opticsensors/monitoring-injection-molding/README.md

# `monitoring-injection-molding`
Integration of temperature and pressure sensors inside the cavity of an injection mold with real-time monitoring. Automatic cycle detection via an inductive proximity sensor or machine trigger. The machine signals (injection pressure, screw speed and screw position) are read on the same DAQ scan as the in-mold sensors, so each detected cycle is saved with all channels time-aligned.

The planned [inspection cell](inspection_cell/README.md) has its own hardware,
software and validation workspace in this repository. It documents automatic
spiral length/diameter measurement and weighing, including the initial Machina
proposal and source files. The cell is still in design; acquisition software is
not yet implemented there.

# Hardware

UPDATE photos: added new connector for machine outputs and rewired 

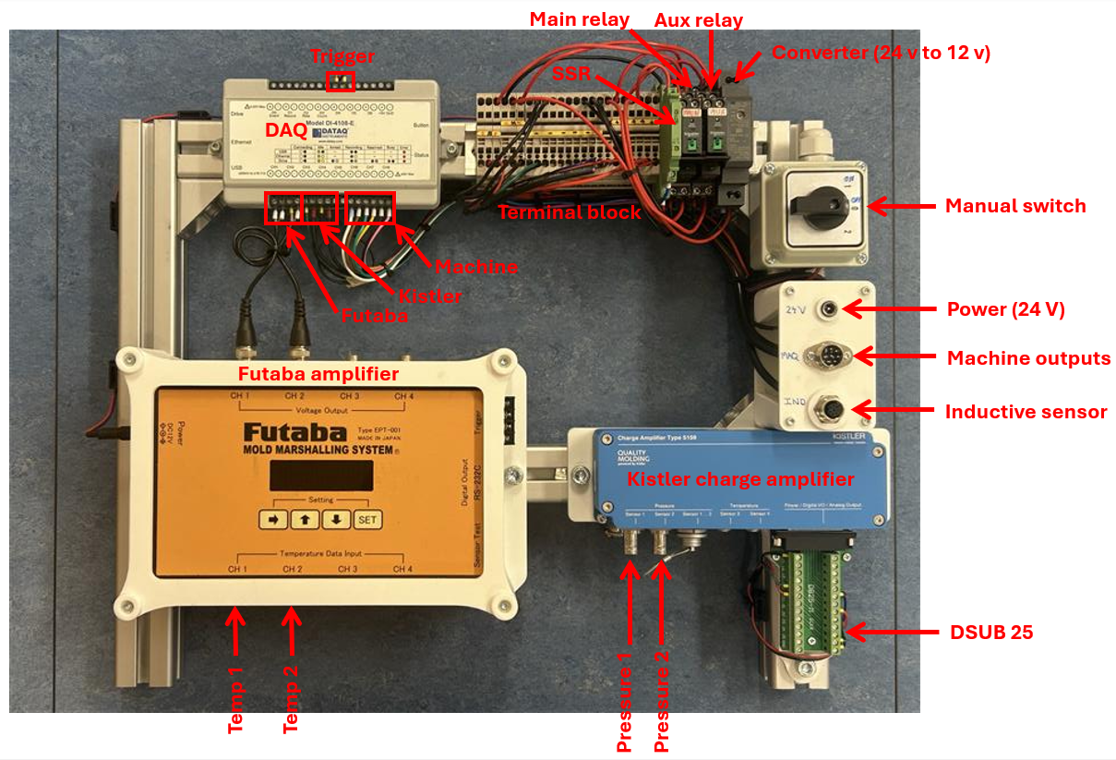
[picture p1: figures/hardware.png]


## Mold sensors:

| Kistler Piezoelectric (0–2000 bar) | Futaba IR (60–430 ºC) | Inductive Proximity | 
|:---:|:---:|:---:|
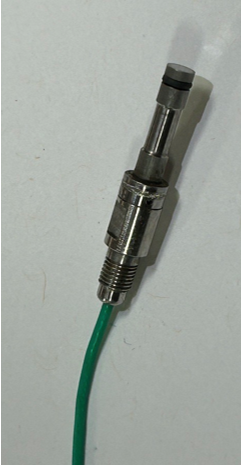
[picture p2: figures/pressure.png]
a
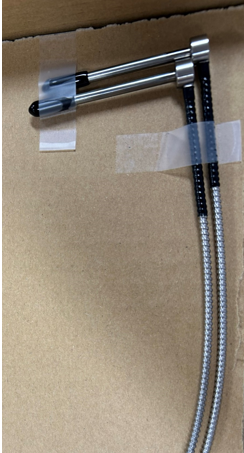
[picture p3: figures/futaba ir.png]
b
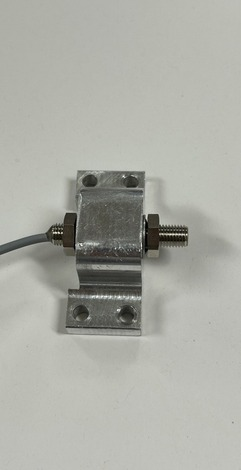
[picture p4: figures/inductive.jpg]
c
|  |  |  |

**Why piezoelectric over piezoresistive?**
Injection molding involves rapid pressure spikes during filling. Piezoelectric sensors excel at capturing these fast, dynamic events with high linearity and are robust under high pressures and temperatures. However, they require charge amplifiers and are unsuitable for long-term static measurements due to drift.

**Why IR over thermocouple?**
IR sensors offer non-contact, fast-response measurement (<8ms) of melt temperature, unaffected by mold conduction. Thermocouples, though cost-effective, can have their melt temperature readings altered by heat conduction from the surrounding mold steel.

## Circuit

The three trigger sources (manual switch, inductive proximity sensor and machine signal) are wired **in parallel onto the main relay coil**, so any of them energizes it and all can be active at the same time.

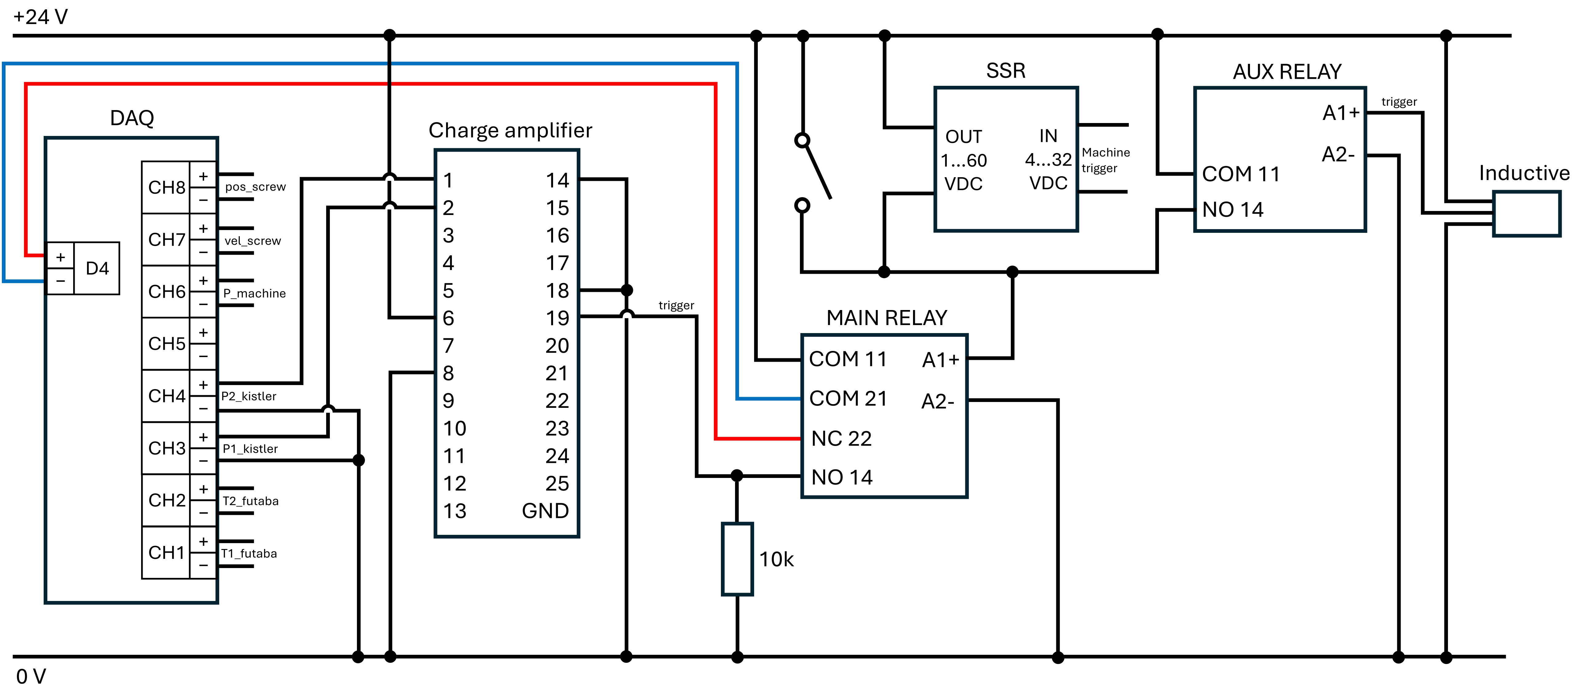
[picture p5: figures/circuit3.png]
Circuit schematic


**Relay Logic**
- Auxiliary relay: converts the inductive sensor's electronic output into a mechanical contact, protecting the sensor electronics from the manual switch's direct 24 V supply.
- Solid-state relay: acts as a switch driven by the machine's 0–10 V output, keeping the machine side isolated from the coil.
- Main relay: two poles. Pole 1 applies the 24 V reset signal to the charge amplifier's trigger/reset input (pin 19), discharging its internal capacitance to eliminate drift; pole 2 (COM 21 / NC 22) is a free contact wired to a DAQ digital input, which tells the program when to record.

**Dry Contact**
The DAQ digital inputs are idle-HIGH (internal pull-up) and only react to being pulled down to ground, hence the voltage-free contact: relay released, the input is grounded and reads 0; relay energized, the contact opens and it reads 1 = cycle running.

**Pull-Down Resistor (10 kΩ)**
Between the main relay's NO contact and ground, it holds the charge amplifier's trigger pin at a defined LOW (0 V) while the relay is open, preventing false triggering from electrical noise.

## Unit conversions:

Every channel is read as a raw ADC count and first scaled to volts. The DAQ input range is ±10 V with a 16-bit signed converter, so 32768 counts = 10 V:

`V = raw × 10 / 32768`

**This application requires ±10 V on every acquired analog channel. Do not change
the input range.** The GUI displays a fixed range and the app enforces it, including
when loading configuration files. The shared `daq_connectivity` library continues
to support other ranges for other applications.

That voltage is then converted per channel type. The values below are the defaults in `config/daq_config_defaults.json`. For the machine signals, `R` is the resolution given by the machine (mV per unit) and `initial` the value at 0 V.

| Signal | Conversion | Default |
|---|---|---|
| Futaba (`T_futaba`) | `°C = V × deg_per_volt` | 100 °C/V |
| Kistler (`P_kistler`) | `bar = V × (Qmax / s) / 10` | Qmax = 20000 pC, s = 2.500 |
| Injection pressure (`P_machine`) | `bar = initial + mV / R` | R = 20 mV, initial = 0 |
| Injection speed (`vel_screw`) | `cm³/s = initial + mV / R` | R = 100 mV, initial = 0 |
| Screw position (`pos_screw`) | `mm = initial + mV / R` | R = 100 mV, initial = 0 |

# Software

UPDATE demo and software (leave that as a reminder for me)

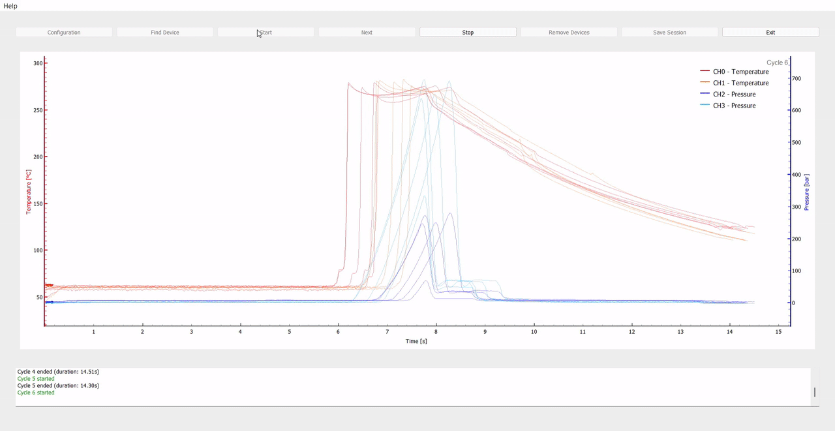
[picture p6: figures/monitoring.gif]
Demo


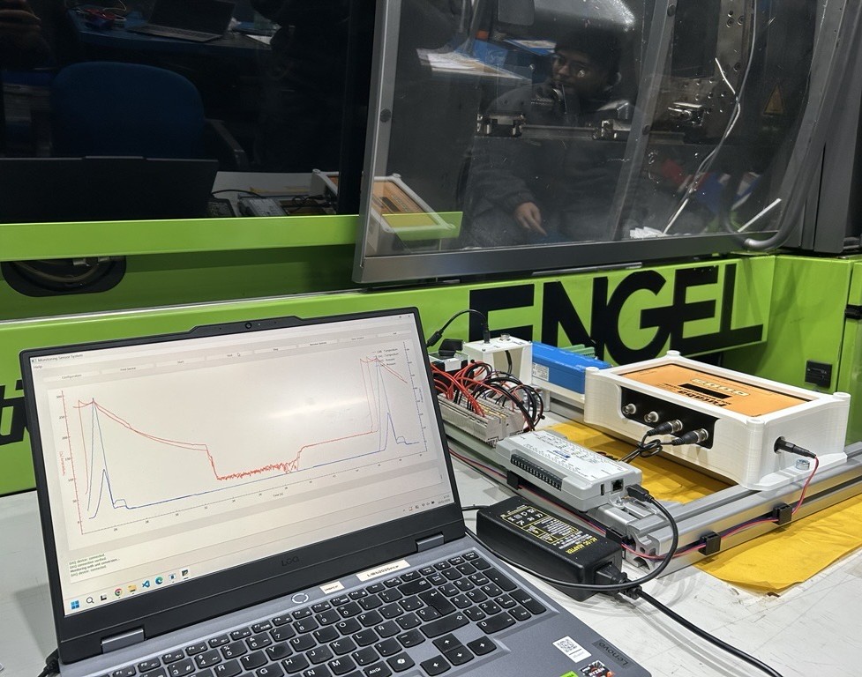
[picture p7: figures/integration.jpg]


Run the application with `py -3.11 main.py`.

- **Setup:** embedded DAQ, Mold sensors, Machine data and Display tabs. Connect/Disconnect controls the single DAQ. Save configuration stages changes for the next recording; Display includes Automatic upload.
- **Monitor:** Start/Stop, New session, Save/Send and plot tools share one toolbar. Enter Machine/Material/Mold/Melt/Speed before Start; they stay fixed for that session. New session focuses these inputs without clearing the stopped recording. Start begins the next session.
- **Part measurements:** Weight/Spiral save automatically after a short pause, Enter or focus change. Monitor follows trigger starts; a field being edited stays attached to its original cycle until you leave it.
- **History:** edit Machine or Material through Spiral directly in a cell. One load icon fetches pages of 10, then refreshes loaded identities and the newest page. Check/select rows to Plot, Exclude, Restore or Send edits.
- **Plots:** each comparison opens in its own closable tab. Its tools and selected-cycle calculations stay independent of Monitor.
- **Offline edits:** pending corrections survive restarts. They send with automatic upload or explicit Send edits; History readback confirms synchronization. Original captures and waveforms remain intact.
- **Save:** exports waveform `.csv`, cycle summary `.cycles.csv`, and `.metadata.json`. Summaries show corrected settings; excluded cycles remain marked in the export. Save again after edits.

MQTT and History share a commissioning `.env` (see [.env.example](.env.example)).
For a OneDrive checkout it lives at `%LOCALAPPDATA%\InjectionMonitoring\.env`;
otherwise the default is the repository's `.env`. `MONITORING_ENV_FILE` overrides
the location for both services. Keep the actual file outside OneDrive and Git.
Set `HISTORY_URL` and `HISTORY_TOKEN` once using the [server guide](iot/SERVER_SETUP.md#desktop-history).
Connection messages appear in the bottom log. Online History and machine corrections require the [server update](iot/SERVER_SETUP.md#desktop-history).

The approved Full inspector layout is shared by `main.py` and the offline demo:
`py -3.11 scripts/preview_layouts.py`. The demo uses synthetic acquisition, a
25-cycle in-memory server and disposable settings; it never opens the DAQ or a
network connection. To render review images, add
`--screenshots data/previews/inspector`.

The inspector defaults to 250 px. Session settings appear only in Monitor;
Setup and History use the full width. Trigger sits below DAQ settings and Machine
variables fills the same width as the other groups. Icons have short tooltips;
their source and license are in `assets/preview/lucide/`.
Analog and digital tables fit their contents without a blank bottom strip;
machine conversion values are centered in their numeric cells.

Measurements entered during an active cycle are saved separately in
`data/active_part_measurements.json`, then transferred to its completed record.
Unfinished measurements after a restart, or measurements from discarded trigger
noise, are retained in that file for recovery and never attached to a new cycle.
Waveforms still require explicit Save or server storage.

## Machine validation

Follow [MACHINE_TEST.md](MACHINE_TEST.md) for a supervised injection test, scan-loss
diagnostics, local exports and server checks. Launch the normal GUI with scan
accounting using `py -3.11 scripts/validate_acquisition.py`.

Use a known-working trigger source. **Machine mold position has an accepted
hardware limitation:** with the documented relay wiring it can keep the Kistler
amplifiers in reset during injection. Software inversion cannot recover that
pressure signal. Repair is deferred; the other working trigger methods remain
available for testing and recording.

The **Sampling divisor (srate)** field is the existing DAQ command parameter,
not a frequency in Hz. Its value, decimation and hardware commands are unchanged.

# IoT

Deploy/update the server from **PowerShell in this repository**:

```powershell
powershell -ExecutionPolicy Bypass -File .\scripts\deploy.ps1
```

Includes Node-RED and Grafana setup. [Server guide and troubleshooting](iot/SERVER_SETUP.md).

Connect to the server:

```shell
ssh -l 'eduard.almar@local.eurecat.org' 172.20.48.28
```

| Service | URL |
|---|-----|
| Grafana | http://172.20.48.28:3000/ |
| Node-RED | http://172.20.48.28:1880/ |

Grafana shows the latest cycles from **55t and 160t combined** (max 100).
This release requires database migrations through **005**, Node-RED and the dashboard together.
Use the deployment command above before using the new desktop's correction features.

Query/export InfluxDB waveforms from a local **WSL/Linux terminal**:

```shell
# Last 5 rows
ssh -l 'eduard.almar@local.eurecat.org' 172.20.48.28 "docker exec influxdb influx -database sensor_data -execute 'SELECT * FROM sensor_data ORDER BY time DESC LIMIT 5'"

# Download CSV
ssh -l 'eduard.almar@local.eurecat.org' 172.20.48.28 "docker exec influxdb influx -database sensor_data -execute 'SELECT * FROM sensor_data' -format csv" > /mnt/c/Users/eduard.almar/Downloads/sensor_data_dump.csv
```

# Installation Manual

## Futaba

| Step | Description | Reference |
|---|---|---|
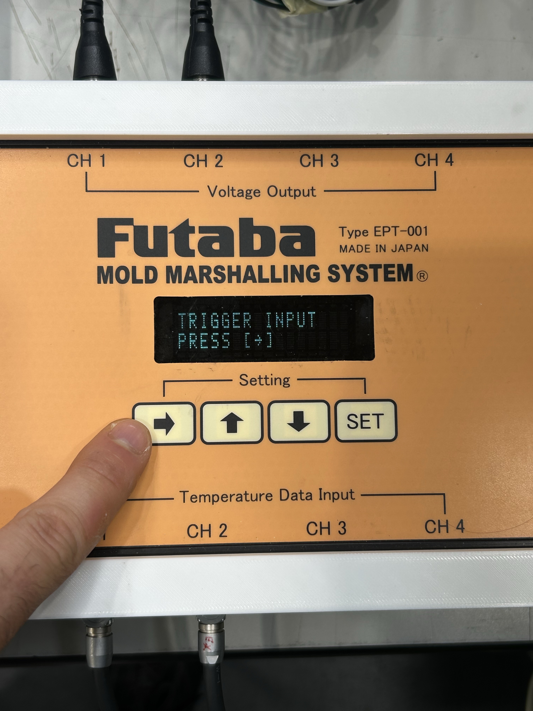
[picture p8: figures/Futaba calibration.jpg]
Futaba calibration
| 1 | Press the calibration button of the amplifier **with the mold open**. |  |
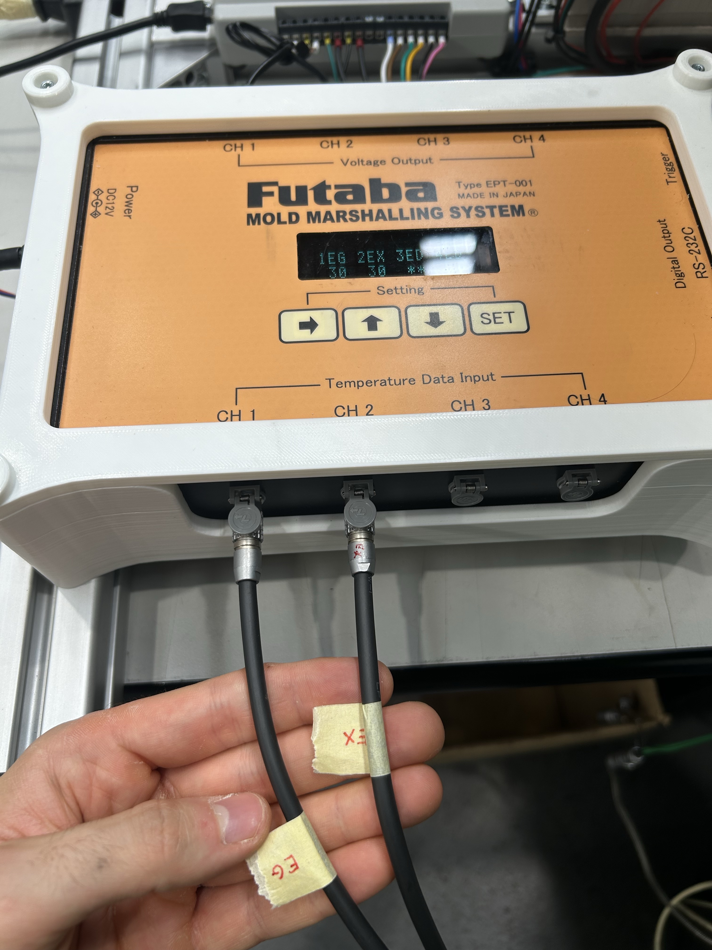
[picture p9: figures/Futaba inputs.jpg]
Futaba inputs
| 2 | Connect the Futaba inputs. |  |
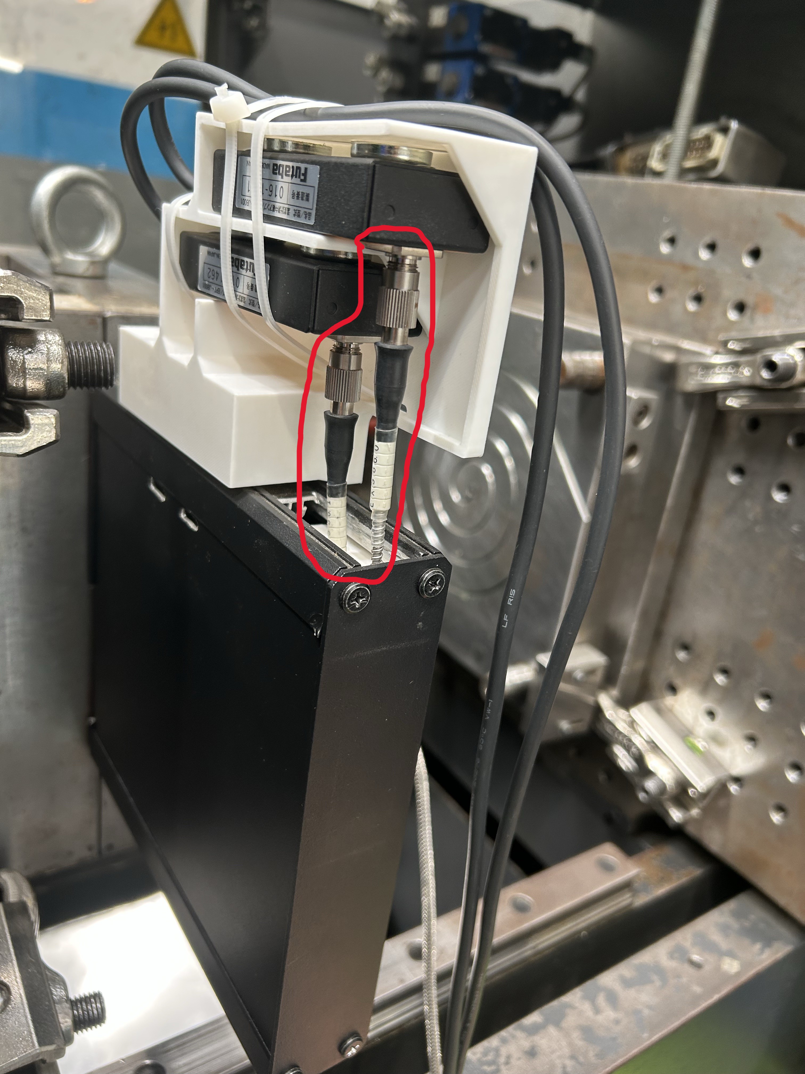
[picture p10: figures/Futaba preamplifiers installation 2.jpg]
Futaba preamplifiers
| 3 | Connect the cables that stick out of the box to the preamplifiers. |  |
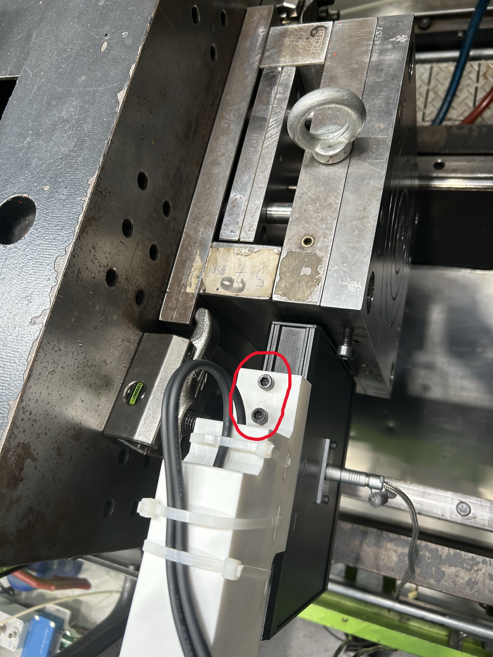
[picture p11: figures/Futaba preamplifiers installation.jpg]
Futaba mounting
| 4 | Secure the preamplifiers using the threaded screws. |  |

## Kistler

| Step | Description | Reference |
|---|---|---|
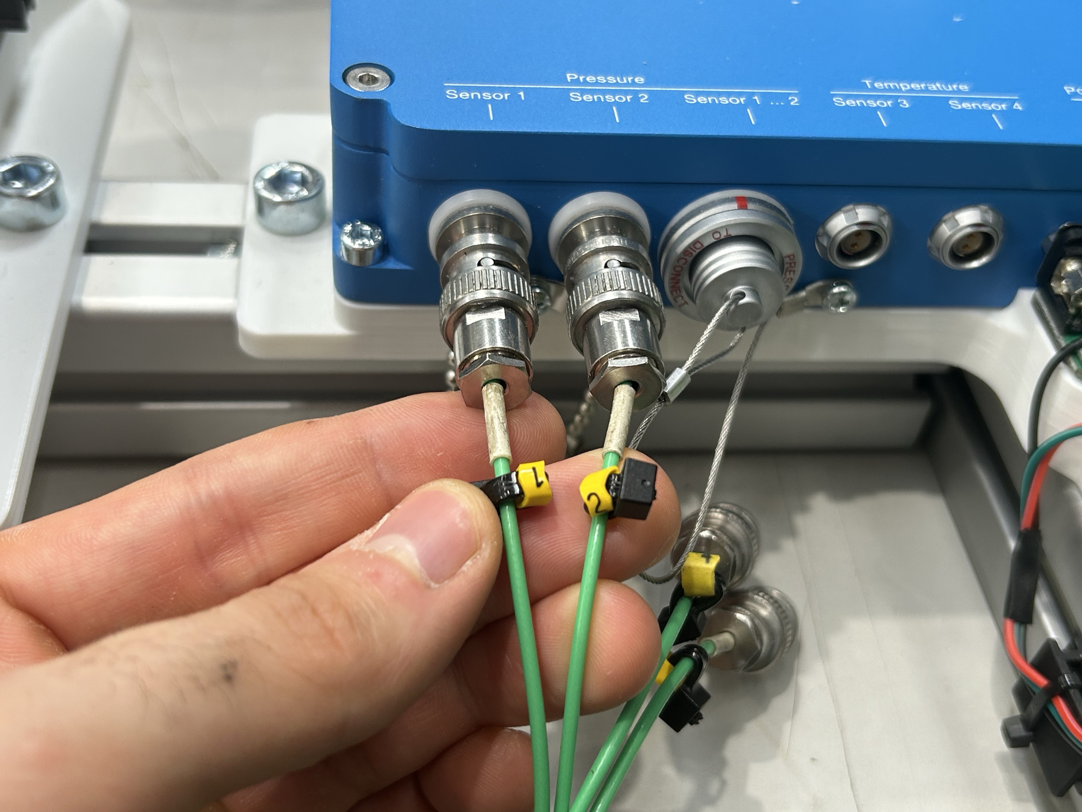
[picture p12: figures/Kistler inputs.jpg]
Kistler inputs
| 1 | Connect the Kistler inputs 1 and 2. |  |
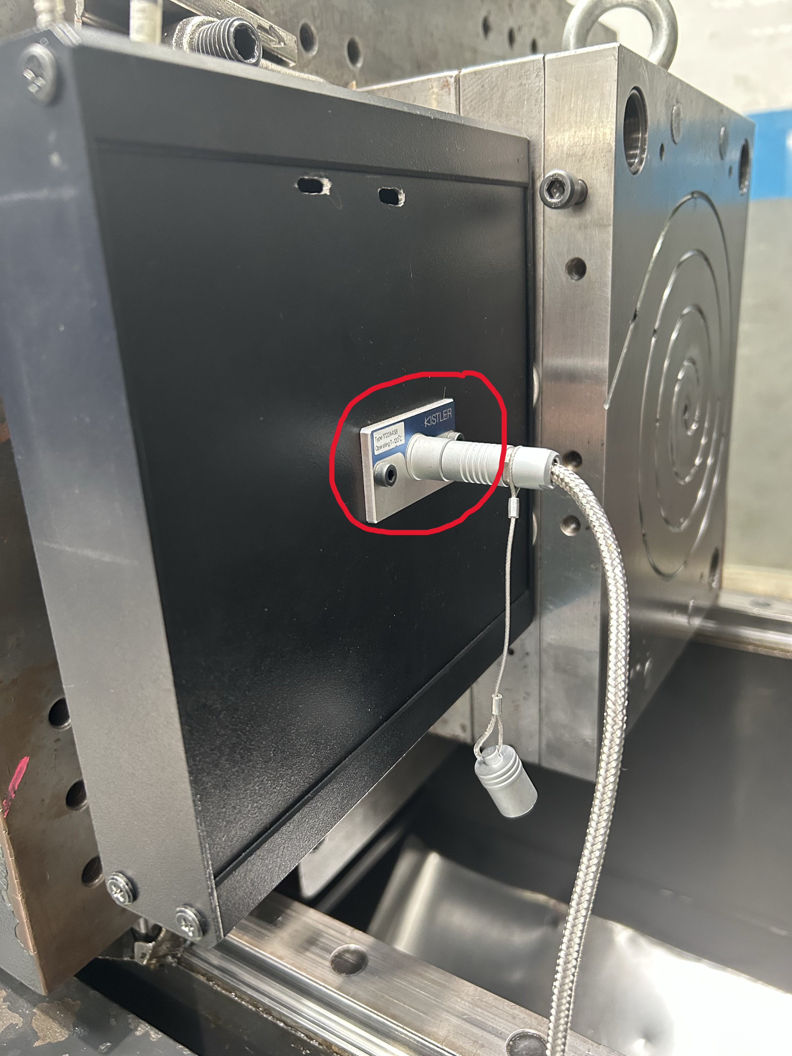
[picture p13: figures/Mold pressure outputs.jpg]
Kistler outputs
| 2 | Connect the mold pressure outputs. |  |

## Final Installation

| Expected result |
|-----------------|
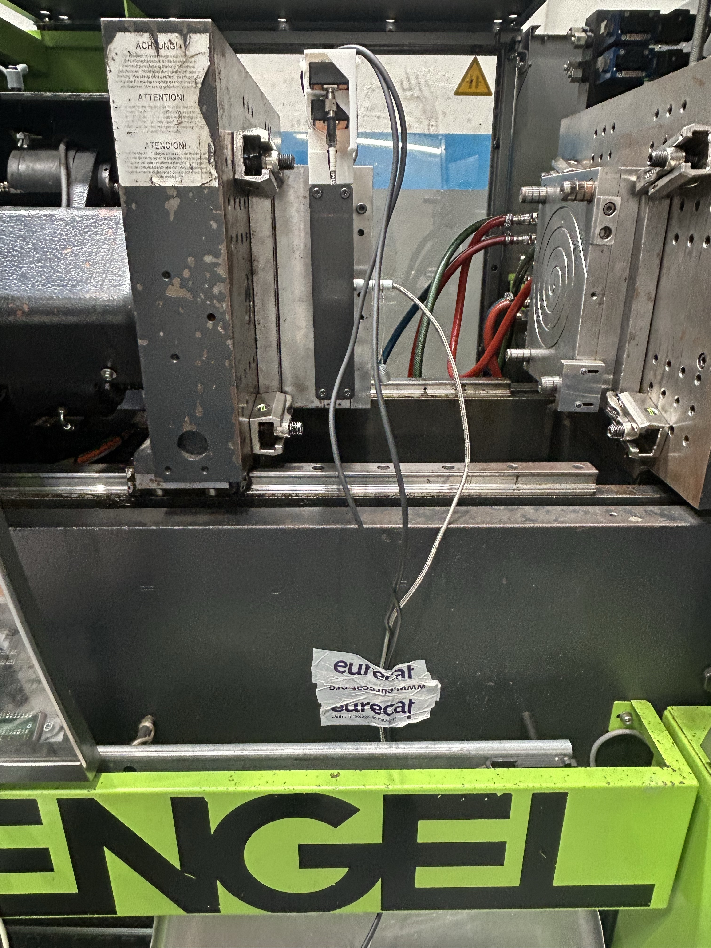
[picture p14: figures/Final result.jpg]
Final installation
|  |
