opticsensors/monitoring-injection-molding/inspection_cell/hardware/README.md

# Hardware de la celda

Estado: concepto inicial, selección pendiente. El punto de partida es cámara 2D cenital, iluminación posterior, soporte transparente, báscula y estructura de perfiles.

| Área | Contenido |
| --- | --- |
| [Investigación](research/README.md) | Qué comparar, por qué y cómo comprobarlo |
| [Componentes](components/README.md) | Candidatos, fichas, oferta y BOM preliminar |
| [Mecánica](mechanical/README.md) | Estructura, colocación, referencias geométricas y CAD |
| [Electricidad](electrical/README.md) | Alimentaciones, conexiones y organización del cableado |
| [Validación](../validation/README.md) | Pruebas antes de aceptar el diseño |

## Orden de trabajo

1. Concretar la magnitud a medir, colada, peso y estado térmico de la pieza.
2. Probar una muestra real sobre una superficie iluminada, con altura y apoyo controlados.
3. Comprobar FOV, escala, deformación, bordes y repetibilidad con óptica/cámara candidatas.
4. Definir la ruta de carga de la báscula y probar lectura automática estable.
5. Dimensionar estructura, fijaciones, conexiones y accesorios con esos resultados.
6. Actualizar selección y BOM con referencias exactas y costes vigentes.

No hay planos de fabricación ni equipos aprobados. Los CAD recibidos pertenecen a la pieza/molde de referencia; no constituyen un diseño de la nueva celda.
