opticsensors/monitoring-injection-molding/inspection_cell/hardware/mechanical/cad/README.md

# CAD

[reference/](reference/README.md) contiene los ficheros recibidos de pieza, molde y elementos asociados. Se copiaron como contexto; no se han abierto en SolidWorks ni se ha comprobado la resolución de enlaces del ensamblaje.

Los futuros diseños de la celda deberán separarse de esas referencias y organizarse por estructura/fixture con revisión y unidades. Añadir, cuando existan, formato nativo, exportación neutral y plano acotado. No presentar un ensamblaje del molde como diseño de la celda de inspección.
