opticsensors/monitoring-injection-molding/inspection_cell/hardware/mechanical/fixtures/README.md

# Soporte y útiles de posicionamiento

Espacio para diseñar el apoyo transparente y las guías de colocación. La espiral puede elevarse localmente hasta unos 10 mm según la descripción del usuario; un útil que limite esa variación debe validarse para comprobar que no altera longitud ni diámetro.

Documentar para cada alternativa: material, espesor, masa, superficies de contacto, apoyo sobre báscula, visibilidad de bordes, espacio de colada, limpieza, condición térmica y tiempo de carga/descarga.

No se ha elegido entre pieza libre, apoyos de posicionamiento o restricción de planitud. La comparación está en [handling.md](../../research/handling.md). Guardar los futuros CAD en [cad/](../cad/README.md) y los ensayos en [validation/reports](../../../validation/reports/README.md).
