opticsensors/monitoring-injection-molding/inspection_cell/hardware/mechanical/frame/README.md

# Estructura y soporte de cámara

Espacio para cálculos, croquis, planos y montaje de base, columna y brazo. No existe todavía un diseño fabricable.

Entradas conocidas: cámara de 36 g y lente de 176,1 g según fichas, a las que se añadirán fijaciones y cargas de cableado. La suma de unos 212,1 g no incluye accesorios. Perfiles candidatos: 20 × 20 y 40 × 40 mm, según la presentación.

Consultar las cotas extraídas de [cámara](../../components/camera_bfs_u3_200s6.md) y [lente](../../components/lens_v7531_mpz.md). El plano de la óptica distingue 79,8 mm a infinito de 81,3 mm máximos; prever acceso a foco e iris y comprobar las referencias de montaje antes de definir la envolvente.

Pendiente: altura de trabajo validada, voladizo, sección y longitud de perfiles, escuadras, anclaje, protección de lente, regulación de perpendicularidad y comprobación de desplazamiento/vibración. Reservar recorrido de cable hasta el PC; el cable ofertado mide 2 m.

Cada futuro plano debe identificar revisión, unidades, referencia de altura, cotas de ajuste y montaje ensayado. Enlazar resultados desde [validation/reports](../../../validation/reports/README.md).
