opticsensors/monitoring-injection-molding/inspection_cell/docs/README.md

# Índice de contexto

| Documento | Contenido |
| --- | --- |
| [Retomar la investigación](research_status.md) | Respuestas recibidas, hallazgos, recomendación provisional y siguiente evidencia útil |
| [Visión general](overview.md) | Propósito, pieza y alcance inicial |
| [Requisitos](requirements.md) | Datos aportados, objetivos y criterios por concretar |
| [Definición de medidas](measurement_definition.md) | Avance de llenado, longitud observada y contracción sin imponer el nominal |
| [Flujo de trabajo](workflow.md) | Colocación, detección, pesaje, fotografía y ciclo |
| [Decisiones](decisions.md) | Acuerdos, propuestas y descartes |
| [Preguntas abiertas](open_questions.md) | Investigaciones prioritarias |
| [Geometría](geometry_reference.md) | Espiral ideal y sensores del molde |
| [Propuesta Machina](presentation_summary.md) | Resumen del PowerPoint con imágenes |
| [Fuentes](sources.md) | Documentos originales, procedencia y referencias externas |

El contexto común se mantiene aquí. Los estudios de selección están en [hardware/research](../hardware/research/README.md), la integración prevista en [software](../software/architecture.md) y los criterios de comprobación en [validation](../validation/README.md).

Fecha inicial de recopilación: 2026-11-04. Las afirmaciones proceden del usuario, de documentos suministrados o de cálculos identificados expresamente. No se ha construido ni ensayado la celda.
