opticsensors/monitoring-injection-molding/inspection_cell/docs/references/README.md

# Documentos de referencia

- [PowerPoint original](Solucion_control_calidad_Machina.pptx): copia byte a byte del documento suministrado, con nombre de archivo normalizado para enlaces.
- [Manifiesto de fuentes](source_manifest.json): origen, destino, tamaño y SHA-256 de copias y medios extraídos.
- [Índice de presentación](presentation_index.json): textos, imágenes y enlaces de sus 11 diapositivas.

Las fichas y la oferta se guardan en [hardware/components](../../hardware/components/README.md). El resumen legible está en [presentation_summary.md](../presentation_summary.md).
