opticsensors/monitoring-injection-molding/inspection_cell/hardware/research/deep_dive_2026-11-04/sources/README.md

# Archivos y procedencia del estudio ampliado

Fecha de consulta: 2026-11-04. Las copias se conservan sin editar. [Manifiesto de descargas](download_manifest.json): URL, fecha, tamaño, SHA-256 y estado. El [índice de evidencias](../evidence_index.json) relaciona conclusiones con fuentes y pruebas pendientes.

## Copias disponibles

| Archivo | Qué se revisó | Interpretación |
| --- | --- | --- |
| [MVTec_1D_Measuring_26_05.pdf](MVTec_1D_Measuring_26_05.pdf) | pp9–11 y 24–26: perfiles en gris, localización de bordes y condiciones de medida | [Análisis](../optics_and_lighting.md) |
| [SCHOTT_BOROFLOAT33_technical_data.pdf](SCHOTT_BOROFLOAT33_technical_data.pdf) | p1: densidad, módulo, expansión y límites de uso | [Análisis](../fixture_and_materials.md) |
| [TPL_CSBACK_Product_Profile_EN.pdf](TPL_CSBACK_Product_Profile_EN.pdf) | p6 y concepto de ajuste: área útil, exterior, potencia y condiciones | [Análisis](../lighting_candidates.md) |
| [AD4212D_system_weighing_manual.pdf](AD4212D_system_weighing_manual.pdf) | pp16 y 44: estática y entorno; no es candidata económica | [Análisis](../weighing.md) |
| [Jones_2011_spiral_flatbed_scanner.pdf](Jones_2011_spiral_flatbed_scanner.pdf) | Artículo completo, especialmente pp3–8: método, sesgo, R&R y límites del escáner | [Análisis](../existing_solutions.md) |
| [USS_DBS28_manual.pdf](USS_DBS28_manual.pdf) | Tabla de familia hasta 3 kg; no sustituye al manual de 5 kg | [Análisis](../weighing.md) |
| [USS_DBS28_30_manual_community_mirror.pdf](USS_DBS28_30_manual_community_mirror.pdf) | Manual de otra revisión alojado por usuario: modos y conexión | [Análisis](../weighing.md) |
| [Harmatys_2021_backlight_uncertainty.xml](Harmatys_2021_backlight_uncertainty.xml) | Método, resultados y discusión; condiciones de luz cambian bordes interior/exterior | [Análisis](../optics_and_lighting.md) |
| [USS_DBS28_61_51_5kg_manual.pdf](USS_DBS28_61_51_5kg_manual.pdf) | PDF p4 / impresa p3: tabla 5 kg; PDF p5 / impresa p7: RS-232 continuo | [Análisis](../weighing.md) |
| [VA_BLBL2_collimated_datasheet.pdf](VA_BLBL2_collimated_datasheet.pdf) | pp1–2: variante 211×200, masa y dimensiones; discrepancia con web | [Análisis](../lighting_candidates.md) |
| [Nimura_2022_camera_thermal_test_stand.xml](Nimura_2022_camera_thermal_test_stand.xml) | Método, montaje, resultados y conclusión; deriva propia de su montaje, no transferible | [Análisis](../optics_and_lighting.md) |
| [NISTIR_6969_2014_rev2015.pdf](NISTIR_6969_2014_rev2015.pdf) | GMP10, PDF pp24–29: desequilibrio térmico, convección y manipulación; no adoptar protocolo entero | [Análisis](../weighing.md) |
| [ITEM_profile_20x20.pdf](ITEM_profile_20x20.pdf) | p1: sección 0.0.370.03, I=0,72 cm4; perfil concreto | [Análisis](../mechanical_frame.md) |
| [ITEM_profile_40x40.pdf](ITEM_profile_40x40.pdf) | p1: sección 0.0.026.03, I=13,96 cm4; perfil concreto | [Análisis](../mechanical_frame.md) |
| [ITEM_profile_deflection.pdf](ITEM_profile_deflection.pdf) | Apartados de material, flexión, torsión y montaje; modelo de voladizo ideal | [Análisis](../mechanical_frame.md) |
| [Micro_spiral_process_fingerprints_2019.xml](Micro_spiral_process_fingerprints_2019.xml) | Método 2.2, materiales y resultados; frente por cuadrantes/ángulo, POM | [Análisis](../existing_solutions.md) |
| [Aminabadi_2022_inline_3D_moulded_parts.pdf](Aminabadi_2022_inline_3D_moulded_parts.pdf) | pp3–12 y 16–17: sujeción, sistema, identificación, repetibilidad sobre piezas estabilizadas 48 h | [Análisis](../existing_solutions.md) |
| [USS_DBS46_300g_manual.pdf](USS_DBS46_300g_manual.pdf) | PDF p4 tabla rasterizada revisada visualmente; p5 modo continuo y conexión | [Análisis](../weighing.md) |
| [Calib_Alu_LDPE_2025.pdf](Calib_Alu_LDPE_2025.pdf) | 4 páginas: tolerancia, planitud y opciones de informe; tabla p1 revisada visualmente | [Calibración](../calibration_references.md) |
| [Calib_Ceramic_2025.pdf](Calib_Ceramic_2025.pdf) | 3 páginas: tolerancia, planitud y opciones de informe; tabla p1 revisada visualmente | [Calibración](../calibration_references.md) |
| [Calib_Print_Lithography_2025.pdf](Calib_Print_Lithography_2025.pdf) | 3 páginas: tolerancia y vidrio/CFRP; tabla p1 revisada visualmente | [Calibración](../calibration_references.md) |
| [Nahita_5173_datasheet.pdf](Nahita_5173_datasheet.pdf) | p2 revisada visualmente: modelo KBD005, capacidad y prestaciones publicadas | [Pesaje](../weighing.md) |
| [Nahita_5173_manual.pdf](Nahita_5173_manual.pdf) | PDF pp4–10: referencias antiguas, salida por MENU y serial; automático pendiente | [Pesaje](../weighing.md) |

Los XML son artículos completos en formato JATS obtenidos de Europe PMC; sus resúmenes legibles están en los estudios. El artículo confocal de 2022 es una copia editorial CC BY alojada por Semantic Scholar. El manual comunitario U.S. Solid está identificado como copia de otra revisión; no reemplaza el manual específico de 5 kg.

## Accesos incompletos

- **Harmatys_2021_backlight_uncertainty.pdf**: 403 Client Error: Forbidden for url: https://www.mdpi.com/1424-8220/21/7/2509/pdf. URL y fecha en manifiesto.
- **EURAMET_cg18_v4_2015.pdf**: 403 Client Error: Forbidden for url: https://iris.inrim.it/retrieve/dd2573c3-0028-e71c-e053-d805fe0ad5dc/I-CAL-GUI-018_Calibration_Guide_No._18_web.pdf. URL y fecha en manifiesto.
- **HX711_AVIA_datasheet.pdf**: 403 Client Error: Forbidden for url: https://datasheet.lcsc.com/lcsc/Avia-Semicon-Xiamen-HX711_C43656.pdf. URL y fecha en manifiesto.
- **EFFILUX_EFFI_BL_datasheet.pdf**: 403 Client Error: Forbidden for url: https://effilux.com/docs/datasheet/DATASHEET-EFFI-BL.pdf. URL y fecha en manifiesto.
- **VA_lens_resolution_v1.5.pdf**: HTTP 404; indexed PDF text available through search, no local file.. URL y fecha en manifiesto.

El fallo de un PDF no significa que no se haya consultado su texto en web. Cada estudio indica el alcance: Harmatys se obtuvo completo en XML; EURAMET/HX711 pudieron leerse en web; la tabla VA de resolución de lente solo se recuperó indexada y no se considera ficha archivada.

Las páginas comerciales y los diez hilos de Reddit se documentan mediante resúmenes/enlaces, sin copiar sitios completos. Los precios son observaciones fechadas; no se ha creado cesta, contactado proveedores ni realizado compras. Las fichas originales de cámara/lente y los primeros manuales están en [datasheets](../../../components/datasheets/README.md).
