opticsensors/monitoring-injection-molding/inspection_cell/hardware/research/handling.md

# Apoyo, colocación y manipulación

La [evaluación ampliada del soporte](deep_dive_2026-11-04/fixture_and_materials.md) incorpora materiales futuros, masas de placas, rutas de carga y el riesgo de imponer la forma nominal. Interesan llenado y contracción; conservar esa distinción al sujetar.

La primera propuesta usa introducción manual sobre un soporte transparente. El usuario plantea que un soporte podría reducir la variación de altura de la espiral. Es una hipótesis a ensayar, no una corrección metrológica garantizada.

## Alternativas para estudiar

| Alternativa | Posible ventaja | Cuestión que resolver |
| --- | --- | --- |
| Placa plana transparente, pieza libre | Carga y descarga sencillas | Persisten alabeo y posición variable |
| Apoyos/guías que posicionan sin forzar | Mejor repetibilidad de colocación | Mantener bordes visibles y conocer altura de apoyos |
| Fixture que controla planitud | Reduce variación de distancia | Comprobar deformación inducida, fuerzas, oclusión y definición de longitud |

## Colada vertical

Medir su altura y relación con el hilo. El usuario prefiere conservarla en fotografías; estudiar cómo acomodarla en el soporte sin ocultar la unión. Si se conserva, evitar que oculte el inicio del recorrido o cree una rama ambigua en la silueta. No dar por medida una zona oculta.

## Interacción con pesaje

Todo el peso que se pretende medir debe llegar a la báscula. El soporte no debe apoyarse a la vez en una estructura fija que derive parte de la carga. Una fijación externa que empuje la pieza también puede alterar el peso.

Estudiar dos disposiciones: panel sobre la báscula con tara de todo el conjunto, o panel fijo separado de una superficie transparente soportada únicamente por la báscula. La segunda necesita un diseño mecánico específico y no se da por resuelta. Documentar fuerzas de cables, holguras, acceso y limpieza.

Los futuros diseños de soporte se guardarán en [mechanical/fixtures](../mechanical/fixtures/README.md), con su condición de uso y ensayos asociados.
