opticsensors/monitoring-injection-molding/inspection_cell/hardware/research/lighting.md

# Iluminación posterior

Actualización: consultar [paneles, masas, precios y préstamos](deep_dive_2026-11-04/lighting_candidates.md) y [efecto de iluminación en el borde](deep_dive_2026-11-04/optics_and_lighting.md). PP es el material inicial; otros materiales/colores requieren comprobación.

## Hipótesis de trabajo

Usar un backlight difuso bajo la espiral para obtener una silueta y reducir la dependencia de anillos o focos laterales. Se priorizan bordes y geometría; color y textura no forman parte del alcance inicial.

Las alternativas industriales y económicas están documentadas con imágenes, enlaces y precios históricos en las [diapositivas 7 y 8](../../docs/presentation_summary.md). Ninguna está seleccionada.

## Comparación pendiente

| Aspecto | Qué registrar |
| --- | --- |
| Superficie útil | Zona que emite luz y margen respecto al FOV; no solo dimensiones exteriores |
| Uniformidad | Imagen sin pieza con la placa/soporte final y exposición fija |
| Estabilidad temporal | Variación entre capturas, calentamiento y posible parpadeo |
| Contraste por material | Gradiente de borde, transmisión de luz por material y dependencia del color/espesor |
| Integración | Masa, espesor, calor, alimentación y posibilidad de disparo/control |
| Soporte transparente | Rayas, suciedad, reflejos, sombras y efecto de la placa en calibración |
| Altura | Cambio de borde/sombra cuando la espiral deja de apoyar |

Las fotografías de la presentación muestran productos con arquitecturas distintas. Un panel de iluminación ambiental o un marco luminoso requiere ensayo antes de considerarlo equivalente a un backlight de visión.

## Ensayo inicial

Capturar el panel vacío, un patrón opaco y varias piezas reales, primero sin fixture y después con el soporte propuesto. Mantener una configuración identificada de cámara. Comparar las medidas con distintas posiciones, alturas y exposiciones; conservar las imágenes originales que expliquen los resultados. Protocolo común: [validación dimensional](../../validation/protocols/dimensional_accuracy.md).
