opticsensors/monitoring-injection-molding/inspection_cell/hardware/research/sources_2026-11-04.md

# Fuentes de investigación — 2026-11-04

Registro para retomar el estudio sin repetir búsquedas. Las páginas comerciales pueden cambiar; precios observados no son cotizaciones aceptadas. Los cálculos y recomendaciones propios están en la [revisión de hardware](2026-11-04_hardware_review.md). Los originales locales del usuario están en [sources.md](../../docs/sources.md).

## Óptica y cámara

| ID | Fuente primaria / comercial | Evidencia usada y conservación |
| --- | --- | --- |
| WEB-O1 | [Computar V3522-MPZ](https://www.computar.com/products/v3522-mpz) | Fabricante; alternativa de 35 mm. [PDF original](https://computarganz.s3.amazonaws.com/Computar+Active+Resources/V3522-MPZ+specs.pdf) guardado como [V3522-MPZ.pdf](../components/datasheets/V3522-MPZ.pdf) |
| WEB-O2 | [Computar V5024-MPZ, PDF](https://computarganz.s3.amazonaws.com/Computar+Active+Resources/V5024-MPZ+spec.pdf) | [Copia local](../components/datasheets/V5024-MPZ.pdf); alternativa de 50 mm |
| WEB-O3 | [Computar catálogo MPZ](https://computarganz.s3.amazonaws.com/Computar+Active+Resources/MPZ+Series_0120.pdf) | [Copia local](../components/datasheets/Computar_MPZ_series.pdf); dos páginas inspeccionadas como imagen; distorsión redondeada a una cifra decimal |
| WEB-O4 | [Edmund Optics: telecentricidad](https://www.edmundoptics.com/knowledge-center/application-notes/imaging/advantages-of-telecentricity/) | Fabricante; fundamento de magnificación y altura. No demuestra precisión de la celda Machina |
| WEB-O5 | [Daheng MER2-2000-19U3M](https://en.daheng-imaging.com/show-106-1998-1.html) | Fabricante; alternativa de cámara IMX183 mono USB3 |
| WEB-O6 | [VA Imaging, MER2-2000-19U3M](https://va-imaging.com/products/usb-camera-3-0-20mp-monochrome-sony-imx183-mer2-2000-19u3m) | Vendedor; 419 € mostrados, impuestos/transporte sin verificar. Lectura directa del texto HTML visible |
| WEB-O7 | [Kowa LM35FC24M](https://www.kowavision.com/products/lm35fc24m) | Fabricante; alternativa de 35 mm, formato 1,1 pulgadas y 24 MP. Precio mostrado 1.202 USD; no seleccionada como ahorro, sin oferta europea comparable |

La extracción automática de Computar incluía etiquetas de «discontinued» ocultas mediante `w-condition-invisible`; no se usaron como evidencia de descatalogación. Otro catálogo global devolvió HTTP 503 y no se archivó: no utilizar sus tablas no verificadas para fijar cotas. El cálculo de distancias del informe es propio y está explícitamente limitado al modelo de lente delgada.

## Pesaje y precios

| ID | Fuente | Evidencia / limitación |
| --- | --- | --- |
| WEB-W1 | [Expondo, SBS-LW-1030](https://www.expondo.es/steinberg-systems-bascula-de-precision-digital-de-0-2-a-3000-g-0-01-g-196-x-160-mm-10031315) | 178 € con IVA, transporte anunciado gratuito; lectura directa y búsqueda web. La disponibilidad/precio de oferta pueden cambiar |
| WEB-W2 | [Manual Expondo](https://manuals.expondo.com/10031315) | [Copia](../components/datasheets/SBS-LW-1030_manual.pdf), 152 páginas multilingües. P10 especificaciones; p13 modos seriales; p45/p48 equivalentes españoles. Validado abriendo PDF aunque contiene bytes antes de la cabecera |
| WEB-W3 | [PCE-BSK 1100](https://www.pce-instruments.com/espanol/balanza/balanza/balanza-de-precision-pce-instruments-balanza-de-precisi_n-pce-bsk-1100-det_5935470.htm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) | Contenido indexado del fabricante: 151,90 € netos / 183,80 € con IVA; accesorio 32,90 €; transporte 8 € netos. Acceso directo irregular; confirmar oferta |
| WEB-W4 | [PCE-BSK 5100, ficha comercial](https://www.pce-instruments.com/espanol/balanza/balanza/balanza-digital-pce-instruments-balanza-digital-pce-bsk-5100-det_5980147.htm) | 166,90 € netos, transporte observado 8–9 €. Especificaciones corroboradas con manual |
| WEB-W5 | [PCE 5100, segunda página](https://www.pce-instruments.com/espanol/balanza/balanza/balanza-de-precision-pce-instruments-balanza-de-precisi_n-pce-bsk-5100-det_5935472.htm) | Mismo precio del equipo, transporte mostrado 90 €; discrepancia que impide presentar un total entregado confirmado |
| WEB-W6 | [PCE manual español enlazado actualmente](https://pim.pce-service.net/upload/files/assets/pce-instruments-m6690f2f6ad2eff0f.pdf) | [Copia](../components/datasheets/PCE-BSK_series_ES.pdf); p3 especificaciones, p8 modos de salida, p9 protocolo. Accedido desde el enlace Manual del producto |
| WEB-W7 | [PCE ficha 5100](https://pim.pce-service.net/upload/files/assets/pce-instruments-e66309f3ce2545e36.pdf) | [Copia](../components/datasheets/PCE-BSK_5100_datasheet_ES.pdf), enlace Ficha técnica del producto |
| WEB-W8 | [PCE manual italiano anterior](https://www.pce-italia.it/html/manuali/man-bilancia-pce-bsk-v1.0-it.pdf) | [Copia](../components/datasheets/PCE-BSK_series_IT.pdf), conserva discrepancia térmica frente al español actual. No usar su rango anterior como especificación vigente |

No se usaron reseñas de compradores como evidencia metrológica ni páginas de desarrollo de Expondo como precio español. El [manual inglés anterior](https://www.pce-instruments.com/english/slot/2/download/5931253/man-precision-balance-pce-bsk-series-en_1408219.pdf) estaba indexado pero su descarga devolvió 403; se consiguió después el español desde el enlace de producto. No hay una copia inglesa ficticia.

## Material, entorno y soluciones existentes

| ID | Fuente | Uso |
| --- | --- | --- |
| WEB-M1 | [PLEXIGLAS GS/XT: ficha de fabricante](https://www.plexiglas.de/files/plexiglas-content/pdf/technische-informationen/211-1-PLEXIGLAS-GS-XT-EN.pdf) | [Copia local](../components/datasheets/PLEXIGLAS_GS_XT.pdf). Densidad, dilatación y temperaturas de servicio; no es una especificación del PP ni de la pieza caliente |
| WEB-M2 | [VIBRA, manual de unidad de pesaje](https://www.vibra.co.jp/files/page_options/global/products/detail/61/enProducts_fileUp03/enProducts_fileUp03.pdf) | [Copia local](../components/datasheets/VIBRA_weighing_manual.pdf), página 10 PDF / 5 impresa. Efectos cualitativos de calor, convección, cargas estáticas y excentricidad; no transferencia de exactitud a otra báscula |
| WEB-S1 | [KEYENCE IM-8000](https://www.keyence.com/products/measure-sys/image-measure/im-8000/) | Referencia de solución comercial de medición 2D; no hay oferta, prueba con espiral ni integración de peso confirmadas |

## Integridad y actualización

Los nueve PDFs descargados conservan los bytes originales. URL, fecha, páginas, tamaño y SHA-256 figuran en el [manifiesto de investigación](../../docs/references/research_2026-11-04_manifest.json). No se modificó el manifiesto de originales aportados por el usuario.

Al retomar: revalidar precios y variantes; actualizar la tabla de básculas y el resumen de contexto si llega una oferta, una medición real o una respuesta de proveedor. Ninguna fuente sustituye las pruebas con la carga, apoyo y temperatura reales.
