opticsensors/monitoring-injection-molding/inspection_cell/hardware/research/spiral_simulator/index.template.html

Cargando…

XYZ

Parámetros×

Cámara

Focalmm

Alturamm

FOV 200 mm

Espiral

Perfil

Desnivelmm

Ondas

Elevaciónmm

Inclinación°

Referencia

Más

Ø idealmm

Eje de giro°

Fase°

Deformación

Plano calibradomm

Cámara Xmm

Cámara Ymm

Relieve visual

ProyecciónNominal

Restablecer

Errores simulados×

Escala%

Distorsión radial%

% en esquina · valor supuesto

Ver proyección

Poner a cero

Medidas · simulación×

Longitud 3D

Longitud en imagen

Error L

Error Ø

Z mín / máx

FOV

Escala en plano

PNGJSONCSV

IsométricaMMB: girar · Ctrl+MMB: desplazar · rueda: zoom · F: ajustarmm
