opticsensors/monitoring-injection-molding/figures/circuit4.jpg

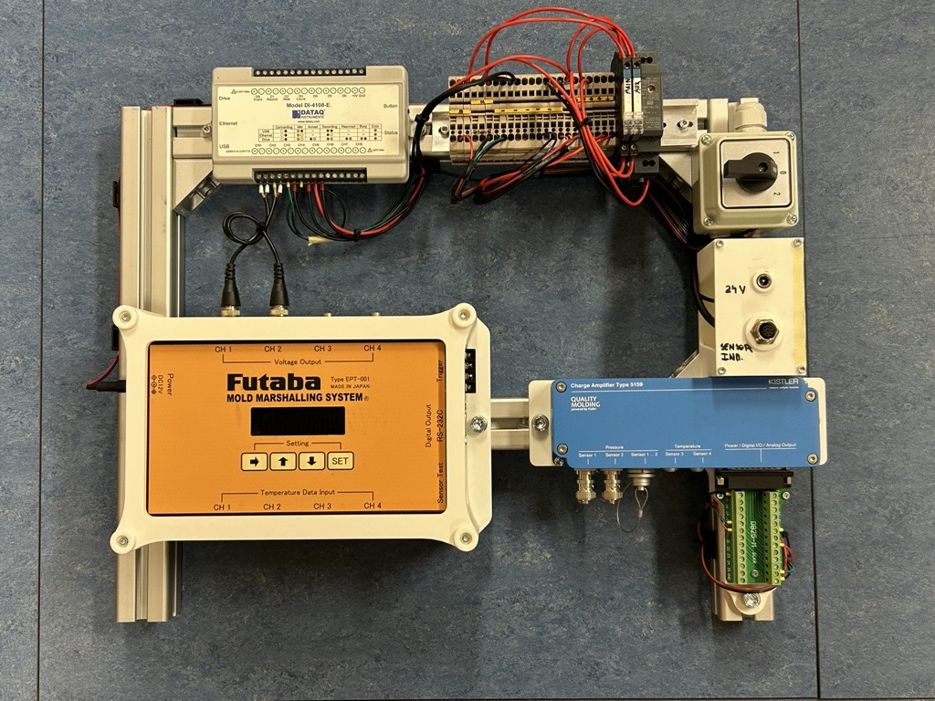
figures/circuit4.jpg
