opticsensors/monitoring-injection-molding/figures/circuit5.png

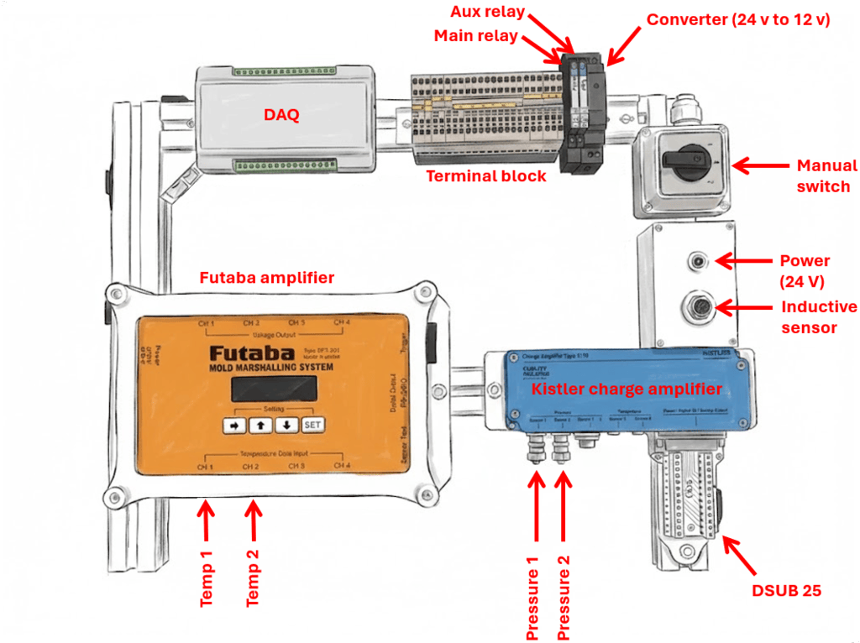
figures/circuit5.png
