opticsensors/monitoring-injection-molding/figures/kistler temp.png

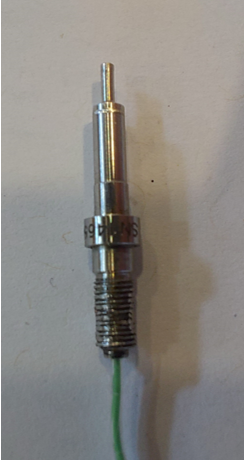
figures/kistler temp.png
