opticsensors/monitoring-injection-molding/inspection_cell/docs/assets/presentation/media/image1.png

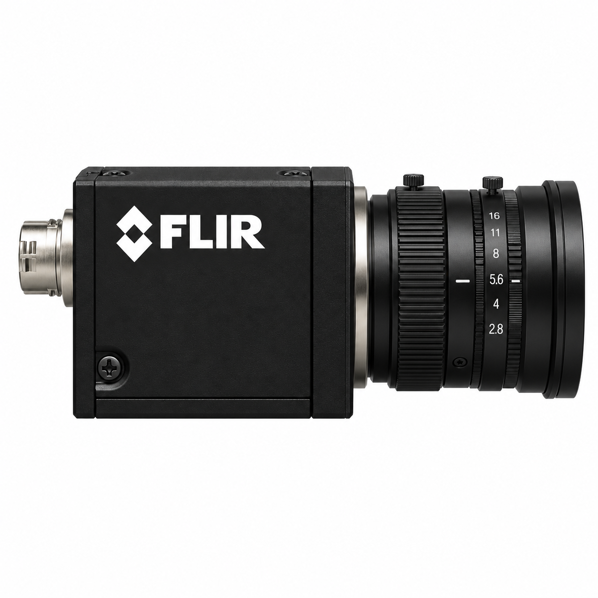
inspection_cell/docs/assets/presentation/media/image1.png
