opticsensors/monitoring-injection-molding/inspection_cell/docs/assets/presentation/media/image2.png

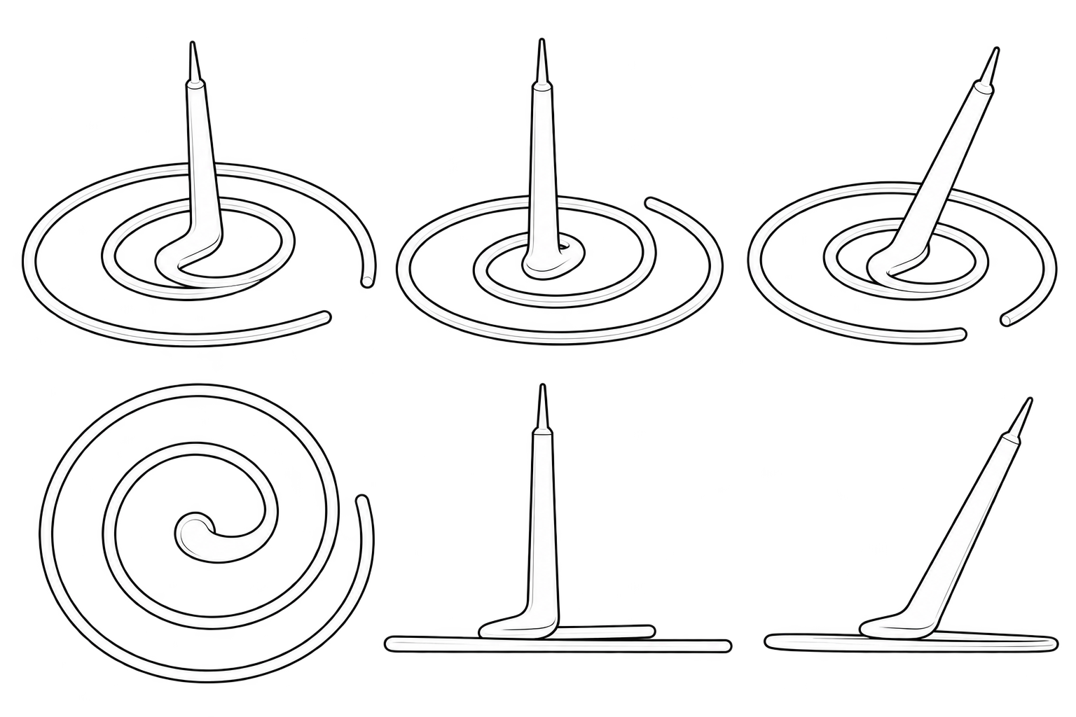
inspection_cell/docs/assets/presentation/media/image2.png
