opticsensors/monitoring-injection-molding/inspection_cell/docs/assets/presentation/media/image3.png

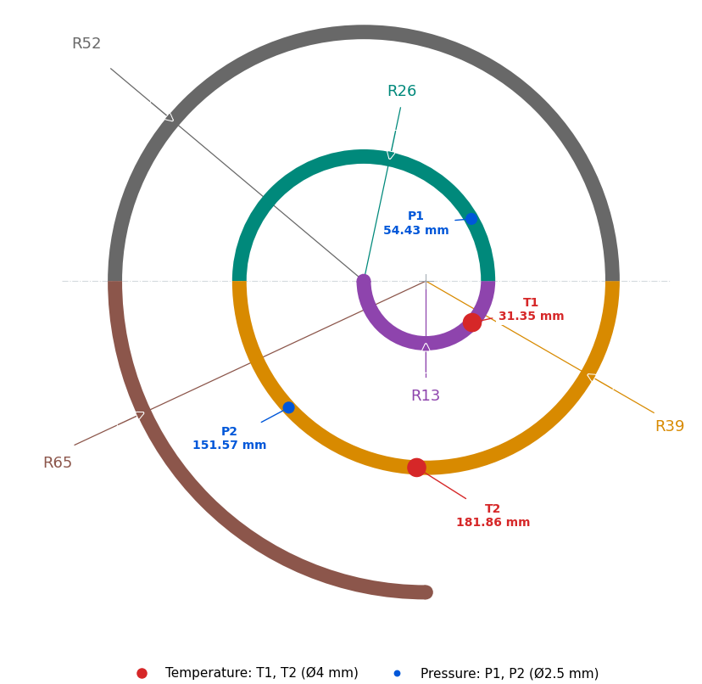
inspection_cell/docs/assets/presentation/media/image3.png
