opticsensors/monitoring-injection-molding/inspection_cell/docs/assets/presentation/media/image4.jpeg

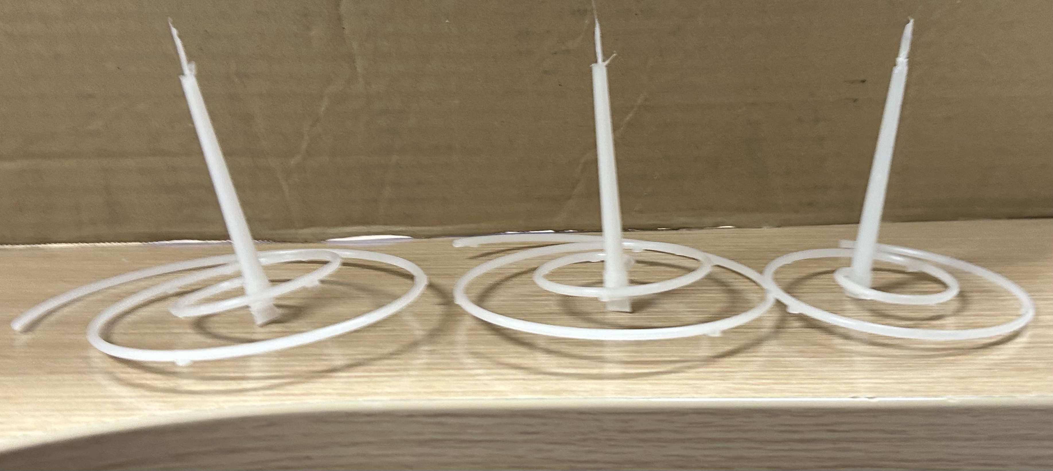
inspection_cell/docs/assets/presentation/media/image4.jpeg
