opticsensors/monitoring-injection-molding/inspection_cell/docs/assets/presentation/media/image5.jpeg

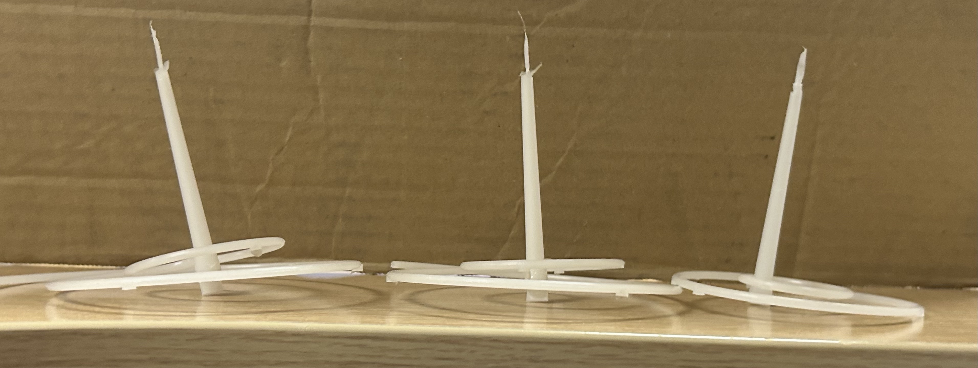
inspection_cell/docs/assets/presentation/media/image5.jpeg
