opticsensors/monitoring-injection-molding/inspection_cell/docs/assets/presentation/media/image6.jpeg

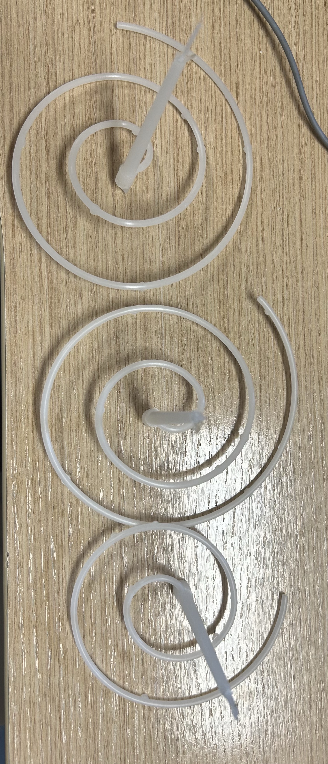
inspection_cell/docs/assets/presentation/media/image6.jpeg
