opticsensors/monitoring-injection-molding/inspection_cell/docs/assets/presentation/media/image7.png

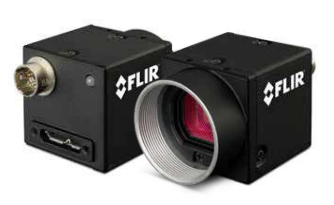
inspection_cell/docs/assets/presentation/media/image7.png
