opticsensors/monitoring-injection-molding/inspection_cell/docs/assets/presentation/media/image8.png

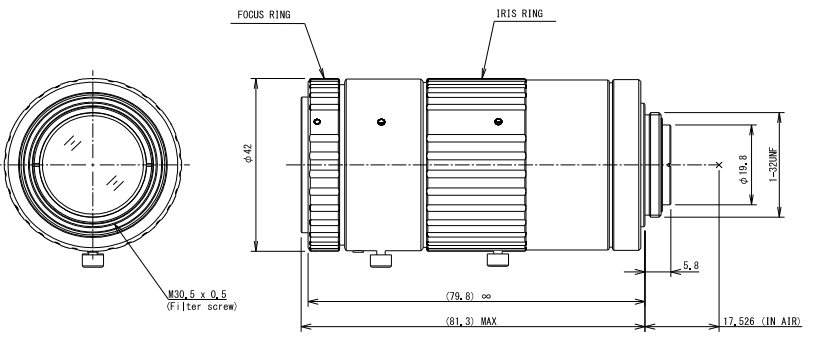
inspection_cell/docs/assets/presentation/media/image8.png
