opticsensors/monitoring-injection-molding/inspection_cell/docs/assets/presentation/media/image9.jpeg

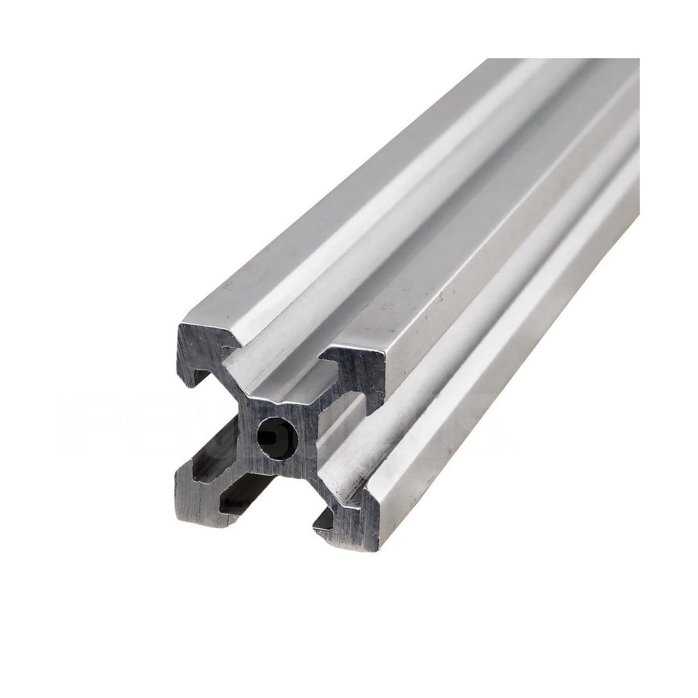
inspection_cell/docs/assets/presentation/media/image9.jpeg
