opticsensors/monitoring-injection-molding/inspection_cell/docs/assets/presentation/media/image10.png

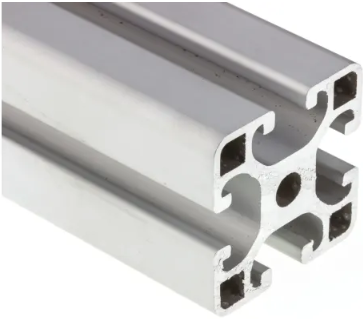
inspection_cell/docs/assets/presentation/media/image10.png
