opticsensors/monitoring-injection-molding/inspection_cell/docs/assets/presentation/media/image11.jpeg

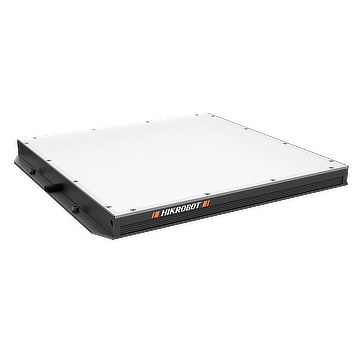
inspection_cell/docs/assets/presentation/media/image11.jpeg
