opticsensors/monitoring-injection-molding/inspection_cell/docs/assets/presentation/media/image12.jpeg

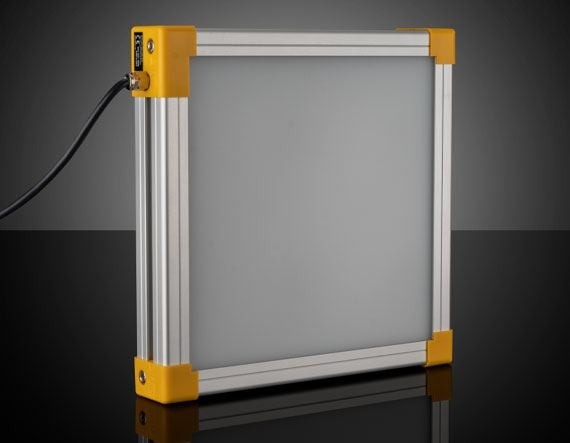
inspection_cell/docs/assets/presentation/media/image12.jpeg
