opticsensors/monitoring-injection-molding/inspection_cell/docs/assets/presentation/media/image13.png

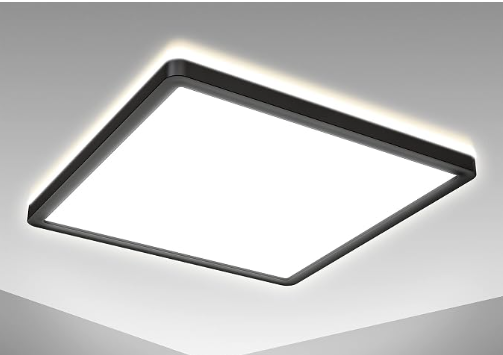
inspection_cell/docs/assets/presentation/media/image13.png
