opticsensors/monitoring-injection-molding/inspection_cell/docs/assets/presentation/media/image15.png

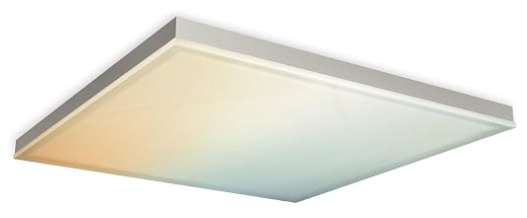
inspection_cell/docs/assets/presentation/media/image15.png
