opticsensors/monitoring-injection-molding/inspection_cell/docs/assets/presentation/media/image16.png

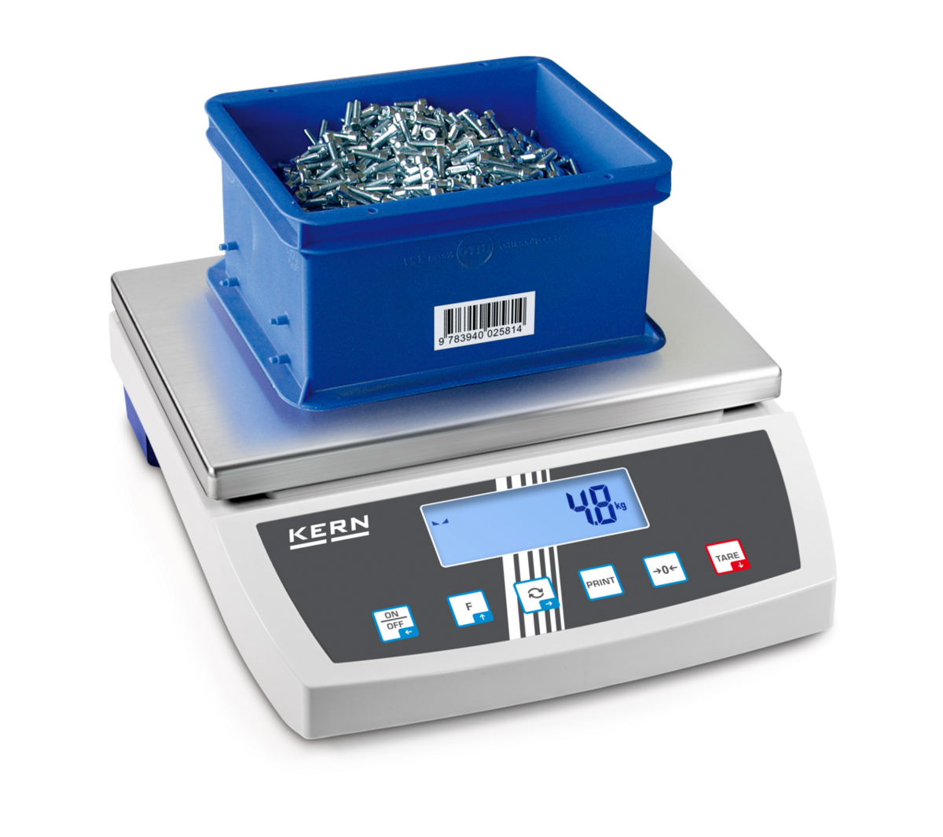
inspection_cell/docs/assets/presentation/media/image16.png
