opticsensors/monitoring-injection-molding/inspection_cell/docs/assets/presentation/media/image17.png

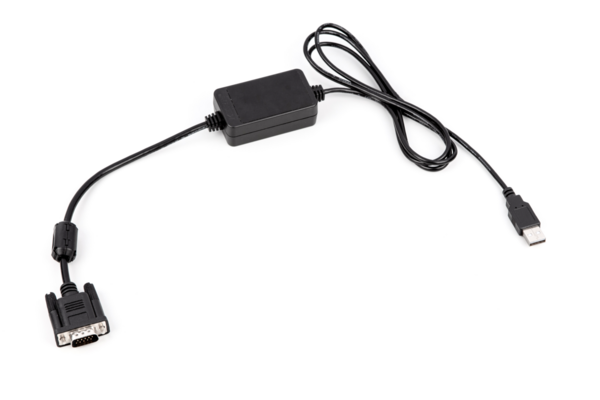
inspection_cell/docs/assets/presentation/media/image17.png
