opticsensors/monitoring-injection-molding/inspection_cell/docs/assets/presentation/media/image18.png

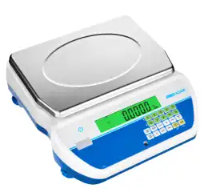
inspection_cell/docs/assets/presentation/media/image18.png
