opticsensors/monitoring-injection-molding/inspection_cell/docs/assets/presentation/media/image19.png

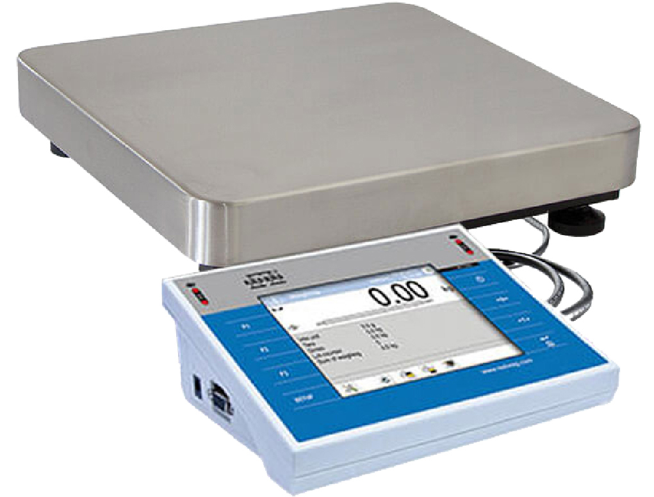
inspection_cell/docs/assets/presentation/media/image19.png
