opticsensors/monitoring-injection-molding/inspection_cell/docs/assets/presentation/media/image20.png

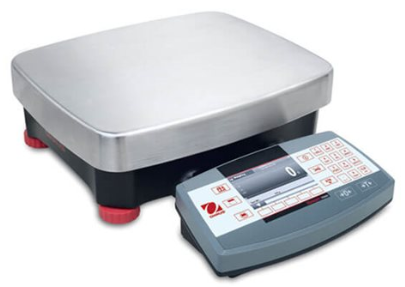
inspection_cell/docs/assets/presentation/media/image20.png
