opticsensors/monitoring-injection-molding/inspection_cell/hardware/components/README.md

# Componentes y documentación comercial

- [Candidatos](candidates.md): alternativas identificadas y preguntas de selección.
- [BOM preliminar](bom.md): elementos necesarios y cantidades todavía por cerrar.
- [Fichas técnicas](datasheets/README.md): copias de los PDF suministrados.
- [Cámara FLIR](camera_bfs_u3_200s6.md) y [lente Computar](lens_v7531_mpz.md): datos técnicos extraídos y notas de integración.
- [Ofertas](quotes/README.md): presupuesto comercial histórico y alcance.

No hay compra ni lista de componentes aprobada. Conservar fabricante, referencia exacta, revisión de ficha, fecha de precio, impuestos, accesorios incluidos y motivo de selección cuando se cierre cada elemento. Registrar las decisiones en [docs/decisions.md](../../docs/decisions.md).
