opticsensors/monitoring-injection-molding/inspection_cell/hardware/components/quotes/README.md

# Ofertas

[IN26-1893.pdf](IN26-1893.pdf) es una copia sin modificar de `Ventas Oferta IN26-1893.pdf`, localizada en Descargas.

- Proveedor: STEMMER IMAGING.
- Fecha: 31/07/2026.
- Alcance: cámara mono BFS-U3-200S6M-C, lente de 75 mm, cable USB de 2 m y transporte.
- Base: 1.137,32 €. IVA: 238,84 €. Total: 1.376,16 €.
- Validez original: 15 días. Se conserva como referencia histórica, no como precio vigente.

Registrar aquí revisiones de ofertas cuando existan, sin sobrescribir la evidencia anterior. La recepción de una oferta no supone compra ni validación de adecuación metrológica.
