opticsensors/monitoring-injection-molding/inspection_cell/hardware/components/bom.md

# Lista preliminar de materiales

Documento de planificación, sin compras aprobadas. Cantidades, longitudes y referencias finales dependen de los ensayos y del diseño. No sumar alternativas mutuamente excluyentes como si todas fueran necesarias.

| Conjunto | Cantidad prevista | Referencia / estado | Coste documentado |
| --- | --- | --- | --- |
| Cámara | 1 | CAM-01 o alternativa CAM-02 | 627,25 € sin IVA para CAM-01, oferta histórica; web oficial observada 620–645,50 € sin IVA según consulta, pendiente de presupuesto. CAM-02 por cotizar con impuestos |
| Lente | 1 | Priorizar LEN-02/LEN-04/LEN-05 (35 mm); LEN-03 si basta campo menor | LEN-02/03 por cotizar; VA 35 mm: 280/350 € observados, fiscalidad y transporte pendientes. Los 475,78 € históricos corresponden a LEN-01 de 75 mm |
| Cable USB cámara | 1 | CAB-01 candidato, 2 m | 24,29 € sin IVA, oferta histórica |
| Transporte del conjunto ofertado | 1 | QUO-01 | 10,00 € sin IVA |
| Báscula | 1 | Comparar WGT-08/05; WGT-06 si apoyo ligero; WGT-07 de menor sensibilidad | [Escenarios económicos](scales_shortlist.md); máximo 300 € con IVA y conexión |
| Interfaz/cable de báscula | Según modelo | Puede requerir adaptador adicional | TBD |
| Panel backlight y controlador | 1 conjunto | Prueba difuso/semicollimado; considerar préstamo | [Paneles, masas y precios](../research/deep_dive_2026-11-04/lighting_candidates.md); fuente/accesorios aparte si no incluidos |
| Fuente de alimentación de iluminación | Según equipo | Confirmar si incluida | TBD |
| Perfiles de columna y brazo | Longitud TBD | 20 × 20 / 40 × 40 por dimensionar | Referencias del PPT: 10/30 €/m |
| Base, escuadras, uniones y tornillería | TBD | Diseño mecánico pendiente | TBD |
| Fijación/ajustes de cámara y lente | 1 conjunto | Diseño pendiente | TBD |
| Soporte transparente y fixture | 1 conjunto | Diseño y masa pendientes | TBD |
| Organización y alivio de tracción de cables | TBD | Según ruta y equipos | TBD |
| Patrón dimensional y referencias de masa | TBD | [Seleccionar según incertidumbre requerida](../research/deep_dive_2026-11-04/calibration_references.md) | TBD |
| PC y almacenamiento | Reutilización por confirmar | Capacidad, USB y ubicación por comprobar | TBD |

La oferta [IN26-1893](quotes/IN26-1893.pdf) suma **1.137,32 € de base + 238,84 € de IVA = 1.376,16 €**. Cubre únicamente sus cuatro partidas; su fecha es 31/07/2026 y la validez original era de 15 días.

La estimación de 2.000–3.000 € del PowerPoint no se toma como presupuesto aprobado ni como coste total validado. Antes de compra, actualizar importes y homogeneizar IVA, transporte, accesorios y costes de fabricación/calibración.
