opticsensors/monitoring-injection-molding/inspection_cell/hardware/components/candidates.md

# Registro de candidatos

Estado a 2026-11-04. Propuestas recibidas y alternativas investigadas; ninguna compra aprobada. Precios y condiciones en la [comparativa de básculas](scales_shortlist.md) y la [revisión de hardware](../research/2026-11-04_hardware_review.md).

| ID | Función | Candidato | Evidencia | Pendiente para seleccionar |
| --- | --- | --- | --- | --- |
| CAM-01 | Cámara | FLIR Blackfly S BFS-U3-200S6M-C, mono | Ficha y oferta | Ensayo óptico, SDK, disparo y PC |
| CAM-02 | Cámara alternativa | Daheng MER2-2000-19U3M | Fabricante y oferta VA Imaging; fuentes WEB-O5/O6 | IVA/transporte, SDK, disponibilidad y ensayo |
| LEN-01 | Óptica | Computar V7531-MPZ, 75 mm | Ficha y oferta CBC-IPZ-V7531 | FOV, distancia, foco, bordes y calibración |
| LEN-02 | Óptica priorizada para estudio | Computar V3522-MPZ, 35 mm | Ficha y catálogo descargados | Distancia frontal real, oferta y validación de campo/bordes |
| LEN-03 | Óptica alternativa | Computar V5024-MPZ, 50 mm | Ficha y catálogo descargados | Campo de 150 mm; con 200 mm supera 1 m en estimación |
| LEN-04 | Óptica alternativa | VA-LCM-20MP-35MM-F2.8-110 | Ficha web, 280 € observados; [comparación](../research/deep_dive_2026-11-04/lens_alternatives.md) | MTF a distancia real, fiscalidad, disponibilidad y prueba con 2,4 µm |
| LEN-05 | Óptica alternativa | VA-LCM-25MP-35MM-F2.8-110 | Ficha web, 350 € observados; [comparación](../research/deep_dive_2026-11-04/lens_alternatives.md) | No inferir superioridad solo de 25 MP; ensayo y precio final |
| CAB-01 | Cable cámara | CEI-USB3-1-1-2-2M, 2 m | Oferta | Alcance real del recorrido hasta PC |
| LGT-01 | Backlight | Hikrobot MV-LBSS-H-250-250-W según enlace | PowerPoint, diapositiva 7 | Área útil, alimentación, uniformidad y control |
| LGT-02 | Backlight | Edmund/EFFILUX #22-098, blanco 200 × 200 | Web: 765 € sin IVA, 1,9 kg; [paneles](../research/deep_dive_2026-11-04/lighting_candidates.md) | Fuente/control, carga/calor admisibles, margen y ensayo |
| LGT-03 | Iluminación de ensayo | B.K.Licht 293 × 293 | PowerPoint, diapositiva 8 | Superficie emisora real y estabilidad de bordes |
| LGT-04 | Iluminación de ensayo | OSRAM SMART PANEL LED 300 × 300 | PowerPoint, diapositiva 8 | Uniformidad, parpadeo e integración |
| LGT-05 | Backlight de ensayo/préstamo | TPL CSBACK2020, colimación ajustable | PDF: área útil 204 × 204, exterior 214 × 214 × 21,1 mm | Masa, precio, préstamo y ensayo |
| LGT-06 | Backlight alternativo | VA-BLBL2-211x200W / COL | Web y PDF; 710 € observados, impuestos pendientes | Distinguir variantes: PDF COL 890 g/20,5 mm frente a web 770 g/18 mm |
| WGT-01 | Báscula | KERN TFKB 8K-4-B, inferido del enlace | PowerPoint, diapositiva 9 | Confirmar modelo, comunicación y metrología |
| WGT-02 | Báscula | Adam Equipment Cruiser | PowerPoint, diapositiva 9 | Modelo exacto y protocolo RS-232 |
| WGT-03 | Báscula | MRC platform balance, modelo TBD | PowerPoint, diapositiva 10 | Identificar variante, interfaces y precio actualizado |
| WGT-04 | Báscula | OHAUS Ranger 7000 R71MD3-EU | PowerPoint, diapositiva 10 | Capacidad con tara, comunicación y precio |
| WGT-05 | Báscula económica | Steinberg SBS-LW-1030, 3 kg / 0,01 g | Página de marca y manual archivado | Repetibilidad, linealidad, pinout/trama y carga excéntrica |
| WGT-06 | Báscula con soporte ligero | PCE-BSK 1100, 1,1 kg / 0,01 g | Fabricante y manual archivado | Masa total <1,1 kg con margen, accesorios y coste entregado |
| WGT-07 | Báscula de mayor capacidad | PCE-BSK 5100, 5,1 kg / 0,1 g | Fabricante y manual archivado | Menor interés: repetibilidad ±0,2 g; confirmar transporte |
| WGT-08 | Báscula económica de mayor capacidad | U.S. Solid USS-DBS28-50, 5 kg / 0,01 g | Manual específico y tiendas oficiales; [pesaje ampliado](../research/deep_dive_2026-11-04/weighing.md) | ±0,03 g manual frente a ±0,02 g web; envío España, USB y precarga |
| WGT-09 | Báscula económica alternativa | U.S. Solid USS-DBS61-32, 3,2 kg / 0,01 g | Ficha oficial alemana, RS-232 | Variante/manual, entrega, plato pequeño y ensayo |
| WGT-10 | Ruta secundaria de plataforma muy ligera | U.S. Solid USS-DBS46-3, 300 g / 0,001 g | Web y manual específico; [estudio](../research/deep_dive_2026-11-04/weighing.md) | Capacidad, campana, discrepancia de repetibilidad, entrega España; no sirve para apilado de 2 kg |
| WGT-11 | Ruta secundaria de 1 mg con canal español | Nahita-Blue KBD005, serie 5173, 300 g / 0,001 g | Auxilab, ficha y manual; [estudio](../research/deep_dive_2026-11-04/weighing.md) | 296,75 € con IVA calculado antes de transporte/conexión; salida automática no confirmada |
| ADP-01 | Adaptador báscula | KERN TYKUP-03-B / KUP-03 según fuente | Enlace e imagen del PowerPoint | Compatibilidad con báscula y host |
| MEC-01 | Estructura | Perfiles V-slot 20 × 20 o 40 × 40 | PowerPoint, diapositiva 6 | Rigidez, altura, uniones y anclaje |
| FIX-01 | Soporte de pieza | Placa/fixture transparente, diseño TBD | Concepto de celda | Efecto en geometría, imagen y pesaje |

Las tablas de especificaciones, fotografías y enlaces originales están en el [resumen de la presentación](../../docs/presentation_summary.md). Las [investigaciones](../research/README.md) definen cómo comparar estos candidatos.

La óptica telecéntrica relatada por el usuario se registra como descartada en [metrología](../research/metrology.md); se localizó una referencia coincidente sin confirmar que sea la ofertada; no se incluye como compra pendiente.
