opticsensors/monitoring-injection-molding/inspection_cell/hardware/components/datasheets/README.md

# Fichas técnicas y manuales

## Originales aportados por el usuario

| Documento | Contenido | Extracción útil |
| --- | --- | --- |
| [BFS-U3-200S6-Datasheet.pdf](BFS-U3-200S6-Datasheet.pdf) | Cámara Blackfly S, variantes mono y color; 2 páginas rasterizadas, revisión v2 | [Cámara: imagen, adquisición, I/O, alimentación y montaje](../camera_bfs_u3_200s6.md) |
| [V7531-MPZ.pdf](V7531-MPZ.pdf) | Computar, lente de 75 mm y montura C; 1 página rasterizada, fecha 2022.07 | [Lente: óptica, FOV de ficha, cotas y compatibilidad](../lens_v7531_mpz.md) |

Copias sin modificar desde `C:\edu\projects\Machina`, verificadas el 2026-11-04. Son idénticas por SHA-256 a las copias previamente obtenidas de Descargas, por lo que se mantienen los mismos nombres de archivo. La procedencia y la verificación están registradas en el [manifiesto](../../../docs/references/source_manifest.json).

Las páginas son imágenes sin texto seleccionable; los datos se extrajeron mediante revisión visual. Las fichas Markdown distinguen valores de fabricante, notas al pie, cálculos y comprobaciones pendientes. El estudio del conjunto permanece en [vision.md](../../research/vision.md). Guardar futuras fichas con su referencia/revisión y actualizar el [registro de fuentes](../../../docs/sources.md).

## Descargas de investigación del 2026-11-04

| Documento original, sin modificar | Uso y páginas relevantes del PDF |
| --- | --- |
| [V3522-MPZ.pdf](V3522-MPZ.pdf) | Computar 35 mm, 1 página. Primera focal alternativa a estudiar |
| [V5024-MPZ.pdf](V5024-MPZ.pdf) | Computar 50 mm, 1 página. Alternativa si basta el campo menor |
| [Computar_MPZ_series.pdf](Computar_MPZ_series.pdf) | Catálogo de 2 páginas; especificaciones en p2, distorsión redondeada a una cifra decimal |
| [SBS-LW-1030_manual.pdf](SBS-LW-1030_manual.pdf) | Manual multilingüe; p10 tabla de modelos, p13 salida serial automática/continua; español p45 y p48 |
| [PCE-BSK_series_ES.pdf](PCE-BSK_series_ES.pdf) | Manual español actual, enlazado desde producto; p3 especificaciones, p8 modos de envío, p9 protocolo |
| [PCE-BSK_5100_datasheet_ES.pdf](PCE-BSK_5100_datasheet_ES.pdf) | Ficha actual de 2 páginas |
| [PCE-BSK_series_IT.pdf](PCE-BSK_series_IT.pdf) | Manual anterior italiano: conserva diferencias con el español actual; no priorizar sus condiciones térmicas |
| [PLEXIGLAS_GS_XT.pdf](PLEXIGLAS_GS_XT.pdf) | Propiedades de PMMA: densidad, expansión y temperatura de servicio |
| [VIBRA_weighing_manual.pdf](VIBRA_weighing_manual.pdf) | Referencia sobre entorno de pesaje, p10 PDF / p5 impresa. No es una báscula seleccionada |

Extracción y consecuencias: [comparativa de básculas](../scales_shortlist.md), [revisión de montaje](../../research/2026-11-04_hardware_review.md) y [óptica](../../research/vision.md). URL, fecha, tamaño y SHA-256: [manifiesto de investigación](../../../docs/references/research_2026-11-04_manifest.json). Acceso y discrepancias: [fuentes web](../../research/sources_2026-11-04.md).

Faltan selección definitiva de báscula, ficha del panel/controlador elegido y confirmación de accesorios y cableado. La disponibilidad de un manual no demuestra funcionamiento del conjunto construido.

## Ampliación: manuales, iluminación y mecánica

Las nuevas copias se guardan una sola vez en [fuentes del estudio ampliado](../../research/deep_dive_2026-11-04/sources/README.md), con URL, fecha y SHA-256 en su [manifiesto](../../research/deep_dive_2026-11-04/sources/download_manifest.json).

- [U.S. Solid 5 kg](../../research/deep_dive_2026-11-04/sources/USS_DBS28_61_51_5kg_manual.pdf): PDF p4 especificaciones y p5 comunicación. Priorizar sobre manuales de otras capacidades.
- [TPL CSBACK](../../research/deep_dive_2026-11-04/sources/TPL_CSBACK_Product_Profile_EN.pdf), p6, y [VA-BLBL2 COL](../../research/deep_dive_2026-11-04/sources/VA_BLBL2_collimated_datasheet.pdf), pp1–2: dimensiones, potencia y masa cuando conste.
- [BOROFLOAT 33](../../research/deep_dive_2026-11-04/sources/SCHOTT_BOROFLOAT33_technical_data.pdf): propiedades, sin aprobar espesor/montaje.
- [Perfiles y cálculo mecánico](../../research/deep_dive_2026-11-04/mechanical_frame.md): fichas item 20/40 mm y guía de flexión.

El índice también contiene manual A&D, guía NIST, guía MVTec y artículos sobre medición de espiral, iluminación y deriva térmica. Los intentos de descarga fallidos están identificados; no se enlazan como PDFs existentes.
