opticsensors/monitoring-injection-molding/inspection_cell/hardware/mechanical/cad/reference/dim espiral.SLDASM

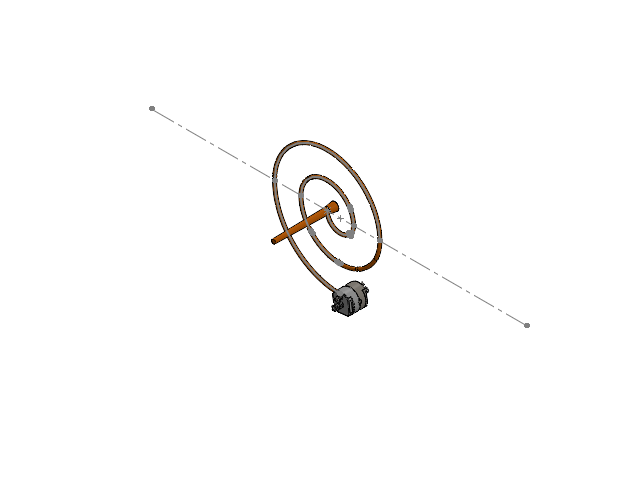
[picture p50: CAD file, 2026-11-05]
inspection_cell/hardware/mechanical/cad/reference/dim espiral.SLDASM
20260812_B_SELECTOR PASO MATERIAL EXPULSION 510 mm
20260812_B_SELECTOR PASO MATERIAL INYECCION 510 mm
socket head cap screw_din(DIN 912 M3 x 10 --- 10S) x 2
E_1530_3_2x9_7_compressed_to_length_7 x 2
20261019_V2 RDI 300_PIEZA ESPIRAL
