opticsensors/monitoring-injection-molding/(list of files, cad)

Other CAD files:
inspection_cell/hardware/mechanical/cad/reference/E_1530_3_2x9_7_compressed_to_length_7.SLDPRT
inspection_cell/hardware/mechanical/cad/reference/20260812_PLACA FIGURA EXPULSION SELECTOR PASO MATERIAL 510 mm.SLDPRT
inspection_cell/hardware/mechanical/cad/reference/20260812_B_SELECTOR PASO MATERIAL EXPULSION 510 mm.SLDPRT
inspection_cell/hardware/mechanical/cad/reference/20261019_V2 RDI 300_PIEZA ESPIRAL.SLDPRT
inspection_cell/hardware/mechanical/cad/reference/socket head cap screw_din(DIN 912 M3 x 10 --- 10S).SLDPRT
inspection_cell/hardware/mechanical/cad/reference/20260812_PLACA FIGURA REFRIGERACION INYECCION SELECTOR PASO MATERIAL 510 mm.SLDPRT
inspection_cell/hardware/mechanical/cad/reference/20260812_B_SELECTOR PASO MATERIAL INYECCION 510 mm.SLDPRT
inspection_cell/hardware/mechanical/cad/reference/20261019_RDI 300 ASSEMBY MOLDE ESPIRAL+ SENSORICA + SELECTOR DE PASO MATERIAL.x_t
