opticsensors/monitoring-injection-molding/figures/Futaba preamplifiers installation 3.jpg

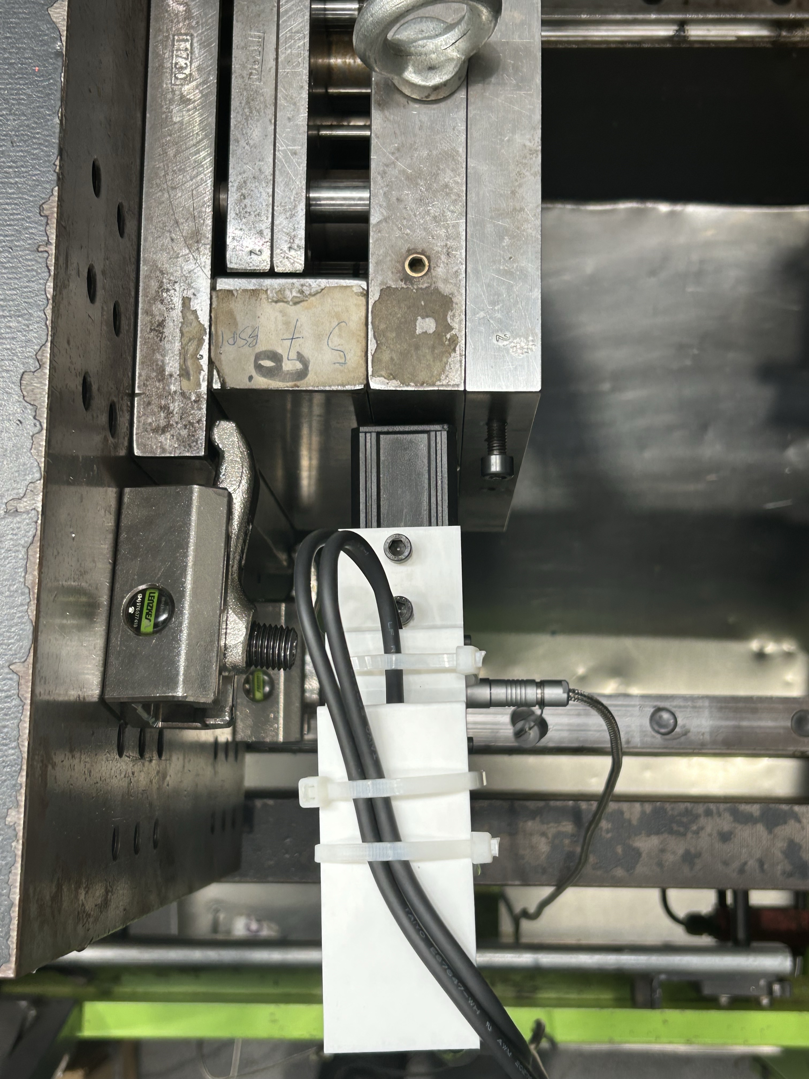
figures/Futaba preamplifiers installation 3.jpg
