opticsensors/monitoring-injection-molding/inspection_cell/validation/templates/bench_record.md

# Plantilla de registro de banco

Copiar a `validation/reports/AAAA-MM-DD_nombre_del_ensayo.md` al realizar una prueba. **Esta plantilla está vacía; no representa un ensayo ejecutado.**

- Fecha/hora, operador, lugar:
- Pregunta concreta que resuelve:
- Pieza(s), material/grado/color, lote/ciclo si se conoce:
- Estado de pieza, tiempo desde desmoldeo y temperatura/método si existe:
- Equipo, modelo, identificación, división/capacidad y calibración conocida:
- Apoyo y elementos que cargan en báscula; masa bruta/tara; cables:
- Cámara/lente/abertura/exposición/ganancia/FOV/altura/plano de calibración, si procede:
- Iluminación y tiempo desde encendido, si procede:
- Referencias usadas y límites de su exactitud:
- Fotos/archivos originales, sin sobrescribirlos:

| Serie | Repetición | Pieza / referencia | Posición / altura | Tiempo desde evento | Lectura original + unidad | Cero tras retirar | Observación / archivo |
| --- | --- | --- | --- | --- | --- | --- | --- |
| Pendiente | | | | | | | |

## Resultado y decisión

- Número de observaciones válidas y descartes con causa:
- Media, desviación típica y rango, separados por condición:
- Sesgo respecto a referencia, solo si la referencia lo permite:
- Qué se ha demostrado:
- Qué no se ha podido comprobar:
- Efecto en elección de cámara/luz/soporte/báscula:
- Siguiente prueba justificada:

No escribir «cumple 0,01 g» solo por dos decimales, ni «±0,1 mm» por tamaño de píxel. No reconstruir lecturas faltantes como si se hubieran observado.
