opticsensors/monitoring-injection-molding/inspection_cell/validation/protocols/dimensional_accuracy.md

# Protocolo propuesto: medida dimensional

Estado: pendiente de ejecutar. Requisitos relacionados: M-01, M-02, M-03 y M-06.

## Preparación

- Definir longitud espacial/proyectada/bajo apoyo, diámetro, regiones de medida y tratamiento de colada.
- Seleccionar referencias con calibración e incertidumbre adecuadas al objetivo. Acordar número de piezas, repeticiones y regla de aceptación antes del ensayo.
- Registrar cámara, lente, FOV, distancia de montaje, apertura, exposición, iluminación, soporte, software y calibración.
- Registrar temperatura y tiempo transcurrido desde la inyección.

## Series de ensayo

1. **Calibración:** patrón en la condición de medida final, con puntos repartidos por el campo. Reservar referencias independientes para evaluar error fuera del ajuste.
2. **Escala y posición:** referencias de ancho conocido en centro y bordes, con varias orientaciones. Conservar imagen original y valores de referencia.
3. **Altura:** elevar referencias con desplazamientos conocidos, incluyendo el rango de deformación observado. Separar pérdida de foco y cambio de escala.
4. **Trayectoria:** validar longitud sobre curvas de referencia y extremos definidos, no solo reglas rectas o diámetro local.
5. **Piezas reales:** comparar con el método de referencia acordado. Recolocar cada pieza para evaluar variación de apoyo y operador.
6. **Fixture:** comparar pieza libre y apoyada/sujeta para detectar cambios mecánicos inducidos.
7. **Robustez:** variar posición, exposición e iluminación dentro del intervalo de operación y probar colada, bordes ocultos y llenado parcial.

## Registro y aceptación

Por cada medida conservar referencia, resultado, error firmado, condición, imagen, identificación de calibración y motivo de invalidez si procede. Informar sesgo, dispersión, extremos e incertidumbre estimada de acuerdo con el plan acordado.

Evaluar longitud y diámetro por separado usando **0,1 mm como orientación**, según aclaración del usuario del 2026-11-04. Informar qué variación queda distinguible frente al ruido de recolocación y a los cambios térmicos reales. No declarar cumplimiento por tamaño de píxel, ajuste sobre la misma imagen de calibración o repetibilidad sola. Si una condición no permite medir la magnitud acordada, documentar la limitación y revisar diseño o especificación.
