opticsensors/monitoring-injection-molding/inspection_cell/validation/protocols/weighing_and_trigger.md

# Protocolo propuesto: pesaje y disparo

Estado: pendiente de ejecutar. Requisitos relacionados: M-04, O-02, O-03 y O-06.

## Preparación

Definir intervalo de peso real, inclusión de colada, error admisible y repetibilidad requerida. Seleccionar referencias de masa adecuadas y registrar su incertidumbre. Montar soporte, iluminación y cables tal como se usarán; identificar qué elementos cargan sobre la báscula.

## Ensayos

1. Registrar tara, deriva y ruido con la plataforma vacía durante un periodo representativo acordado.
2. Medir referencias en el intervalo de trabajo y distintas posiciones de carga. Añadir incrementos conocidos de 0,01/0,02/0,05/0,1 g sobre la **precarga final**, según disponibilidad e incertidumbre de patrones. Informar cuáles se distinguen realmente.
3. Repetir carga/descarga de piezas reales recién desmoldeadas y comprobar estabilidad/deriva. Comparar condición fría como control sin sustituir el estado de inspección solicitado; comprobar panel encendido y calentamiento repetido del soporte.
4. Variar suavemente la posición de cables y verificar que no alteran el resultado aceptado.
5. Determinar umbrales y ventanas con los datos anteriores. Probar mano, colocación lenta, retirada parcial y dos piezas.
6. Verificar una captura por colocación válida y rearme solo tras retirada estable.
7. Probar pérdida de conexión, lectura inválida, sobrecarga y retirada durante la exposición.
8. Registrar lectura estable y fotografía con sus tiempos; comprobar que corresponden a la misma colocación.

## Evidencia

Guardar lecturas, tiempos, eventos, imágenes, referencias y configuración. Informar error, dispersión y mínimo incremento distinguible, además de eventos de disparo. El usuario desea 0,01 g y considera 0,1 g un mínimo justo; los decimales de pantalla por sí solos no determinan aceptación. Priorizar primero la validación física del pesaje; las pruebas completas de software se harán cuando exista la aplicación.
