opticsensors/monitoring-injection-molding/(commit log)

2026-05-05 corrected circuit
2026-07-21 Bring app modules under version control + session fixes
    Commits the previously-untracked application modules (config, config_window,
    sensor_types, app_logging, mqtt_publisher, plot_tools, plot_icons, DAQ scripts,
    Node-RED/Grafana artifacts) alongside this session's changes:
    - DAQ: reuse the open serial connection on Next (rearmDaq + idempotent
    discovery) instead of close+reopen, fixing "Acceso denegado" on reconnect.
    - Plots: scene-level relayout so the machine tab no longer collapses to a
    sliver after Next; matplotlib-style zoom rectangle (black outline, no fill);
    live t / x-y coordinate readout (bottom-right, per tab).
    - Toolbar: cycle number moved off the plot into the readout box;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
